M17-Project/M17_Repeater/schematics/tx_board_new/tx_board.pdf

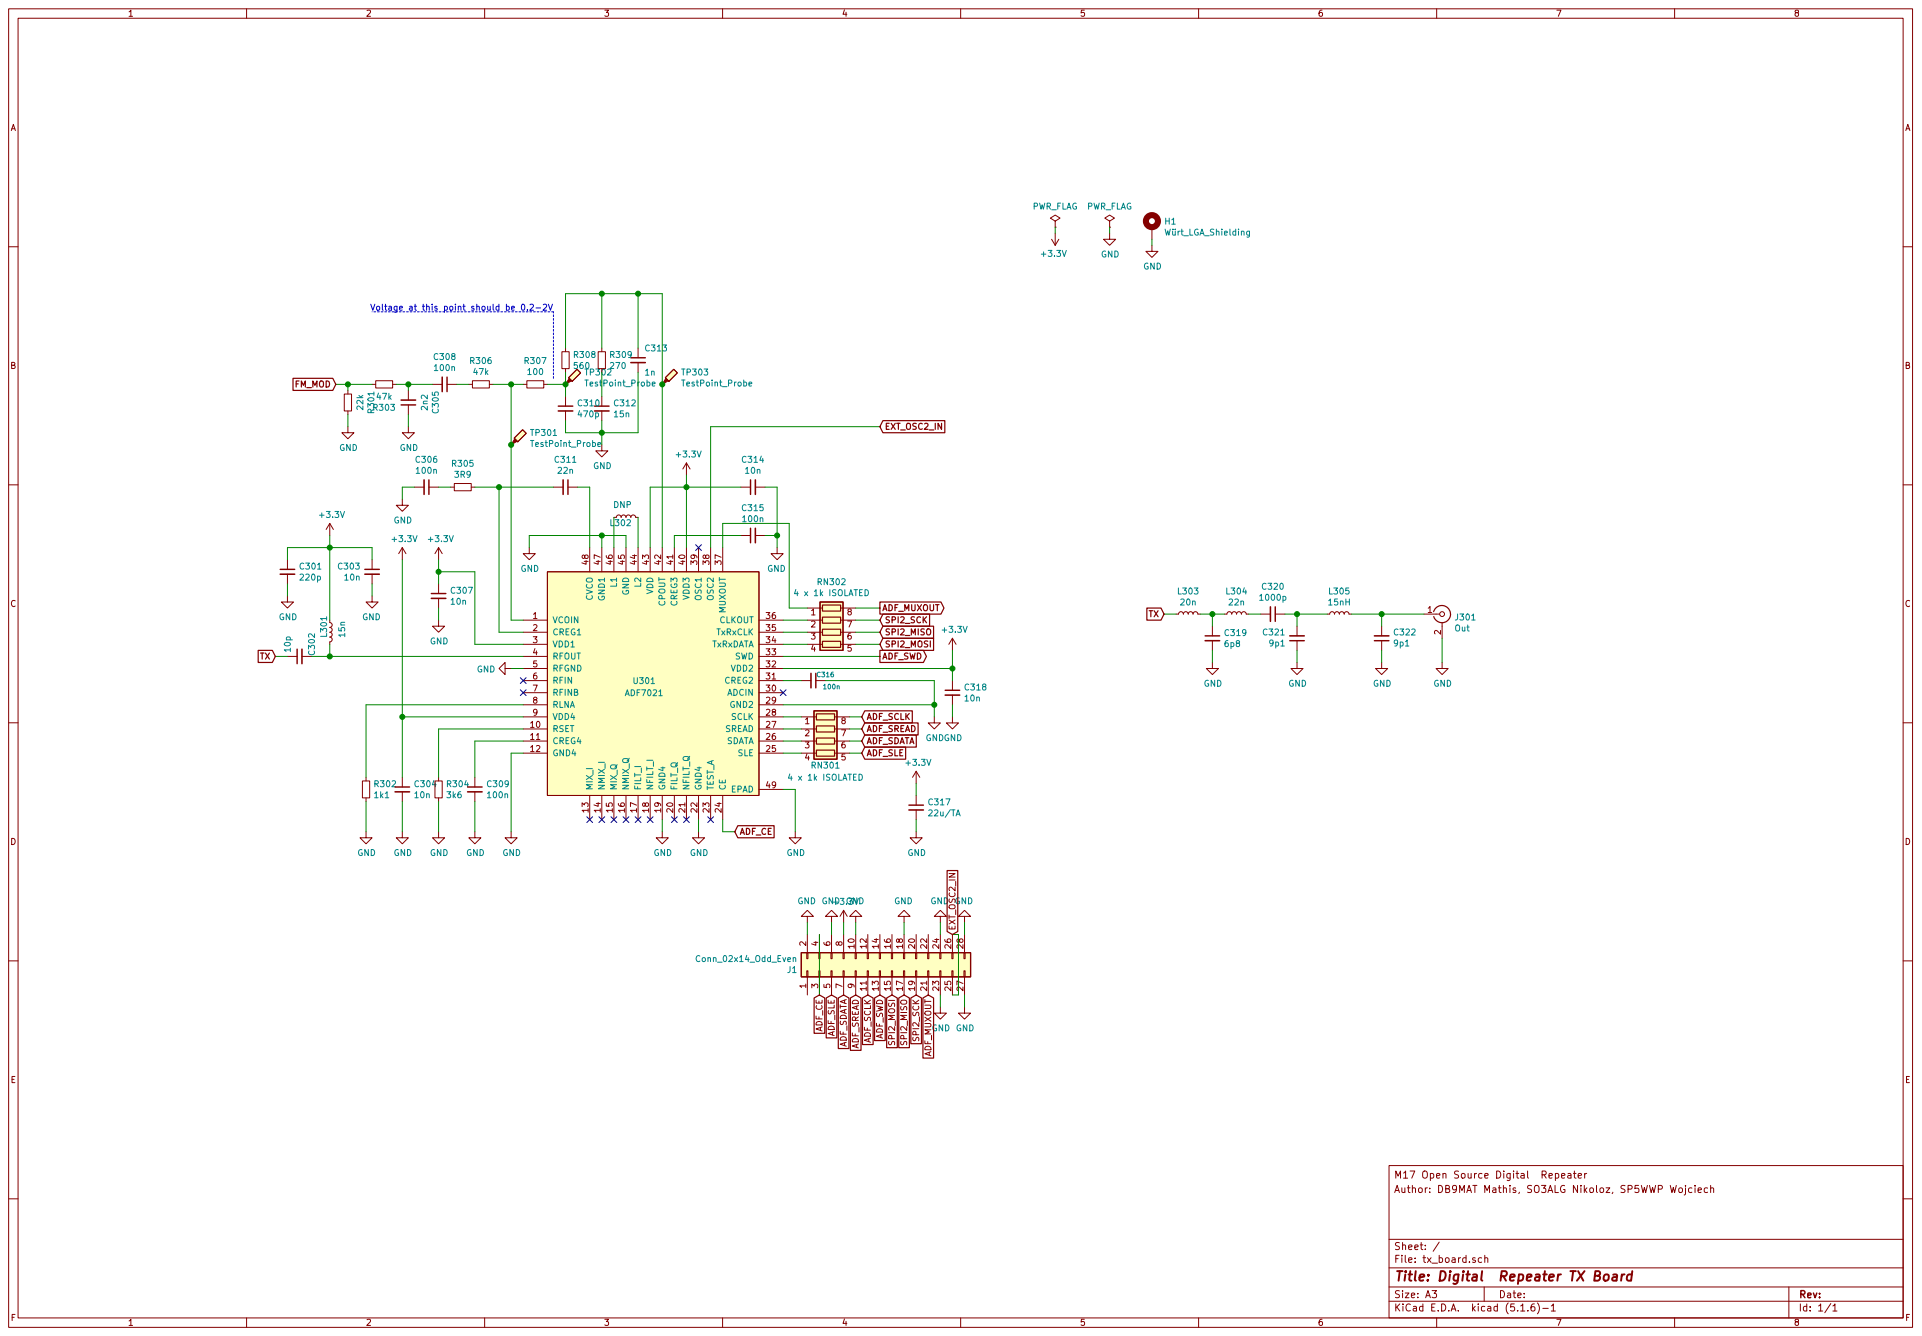
[picture p1: page 1]

SPI2_MOSI Voltage at this point should be 0.2-2V

M17 Open Source Digital Repeater
File: tx_board.sch Sheet: / Author: DB9MAT Mathis, SO3ALG Nikoloz, SP5WWP Wojciech

Id: 1/1 Title: Digital Repeater TX Board
