M17-Project/M17_Repeater/schematics/rx_board/rx_board.pdf

# GND ⁺³V³

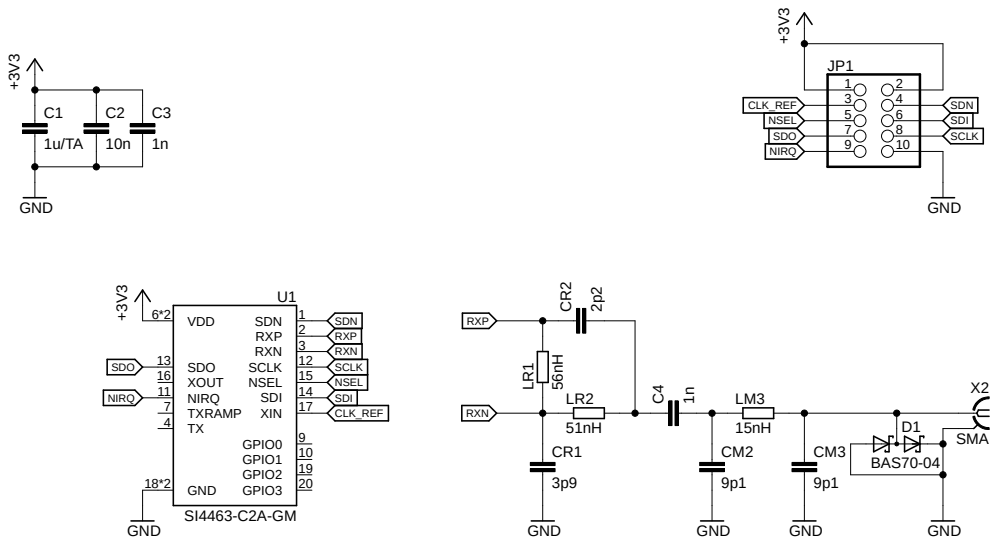
[picture p2: page 1]
SMA; 15nH ⁵⁶nH; GND; GND ⁺³V³; BAS70-04 ¹n; SDN; RXP; RXN; VDD 6*2; TXRAMP 7; GPIO0; GPIO1; NIRQ 11; SCLK; 12 SDO 13; SDI; 14 NSEL; 15 XOUT 16; XIN; GND 18*2; GPIO2; GPIO3; LM3 LR¹; CM3 CR²; CLK_REF; NSEL; SDO; NIRQ
