M17-Project/M17_Repeater/schematics/mainboard/mainboard.pdf

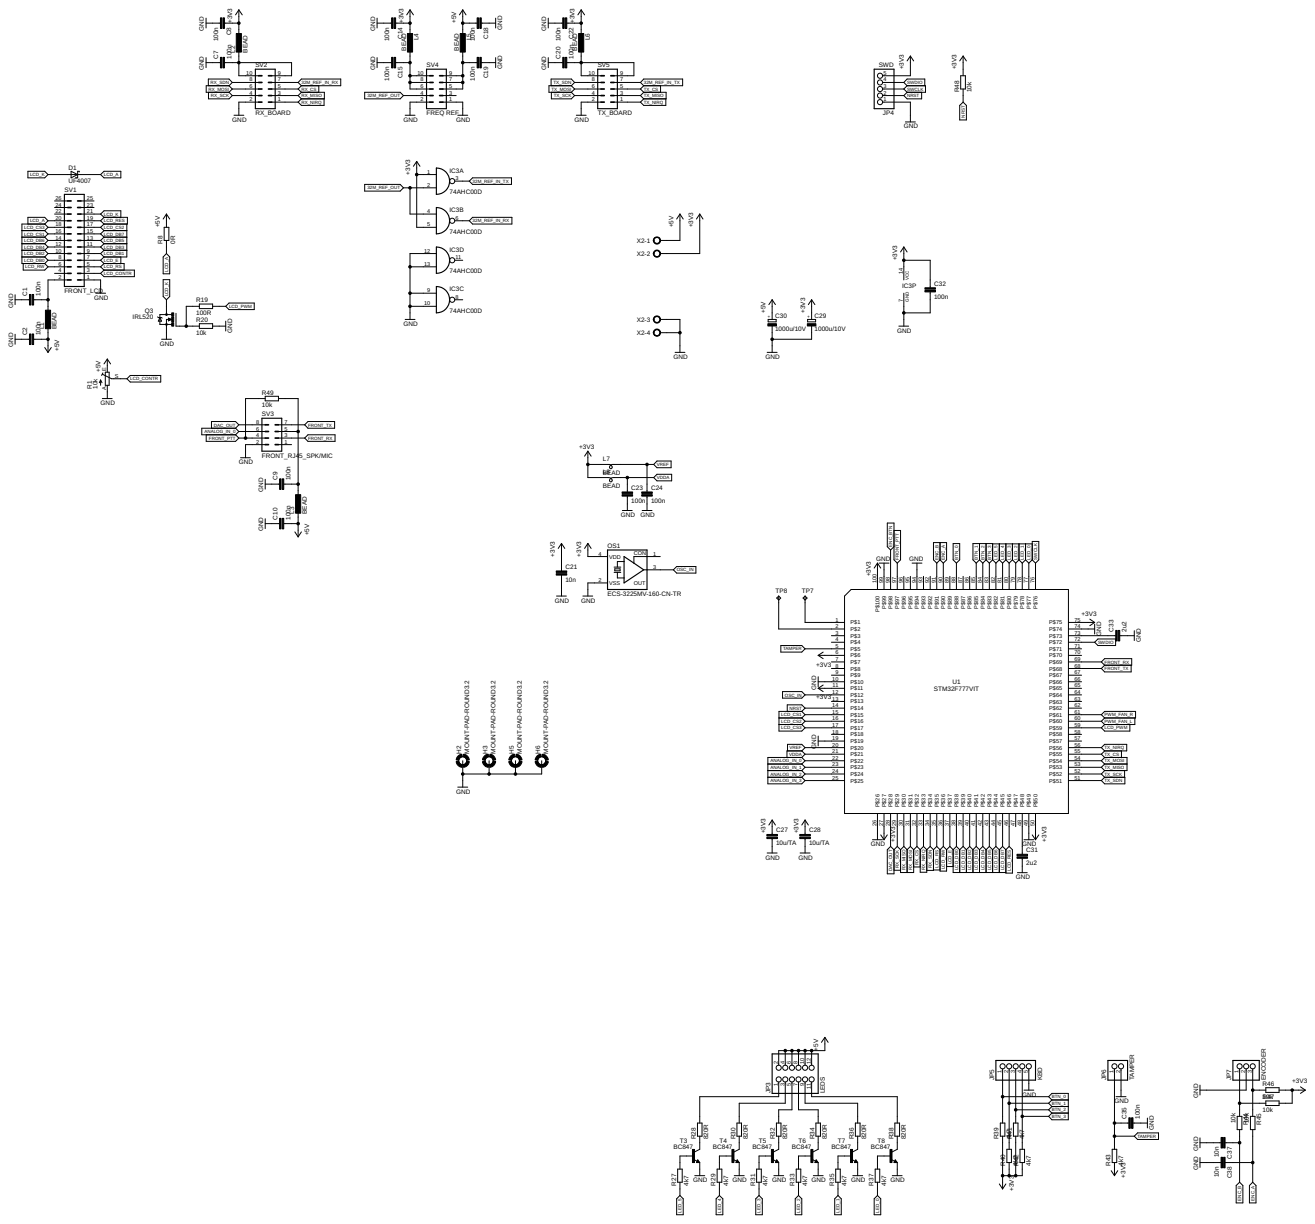
[picture p3: page 1]

4 | 3 1

MOUNT-PAD-ROUND3.2 MOUNT-PAD-ROUND3.2 MOUNT-PAD-ROUND3.2
