M17-Project/M17_Repeater/schematics/tx_board_new/tx_board.kicad_pcb

## KiCad design schematics/tx_board_new/tx_board.kicad_pcb (2020-09-21)

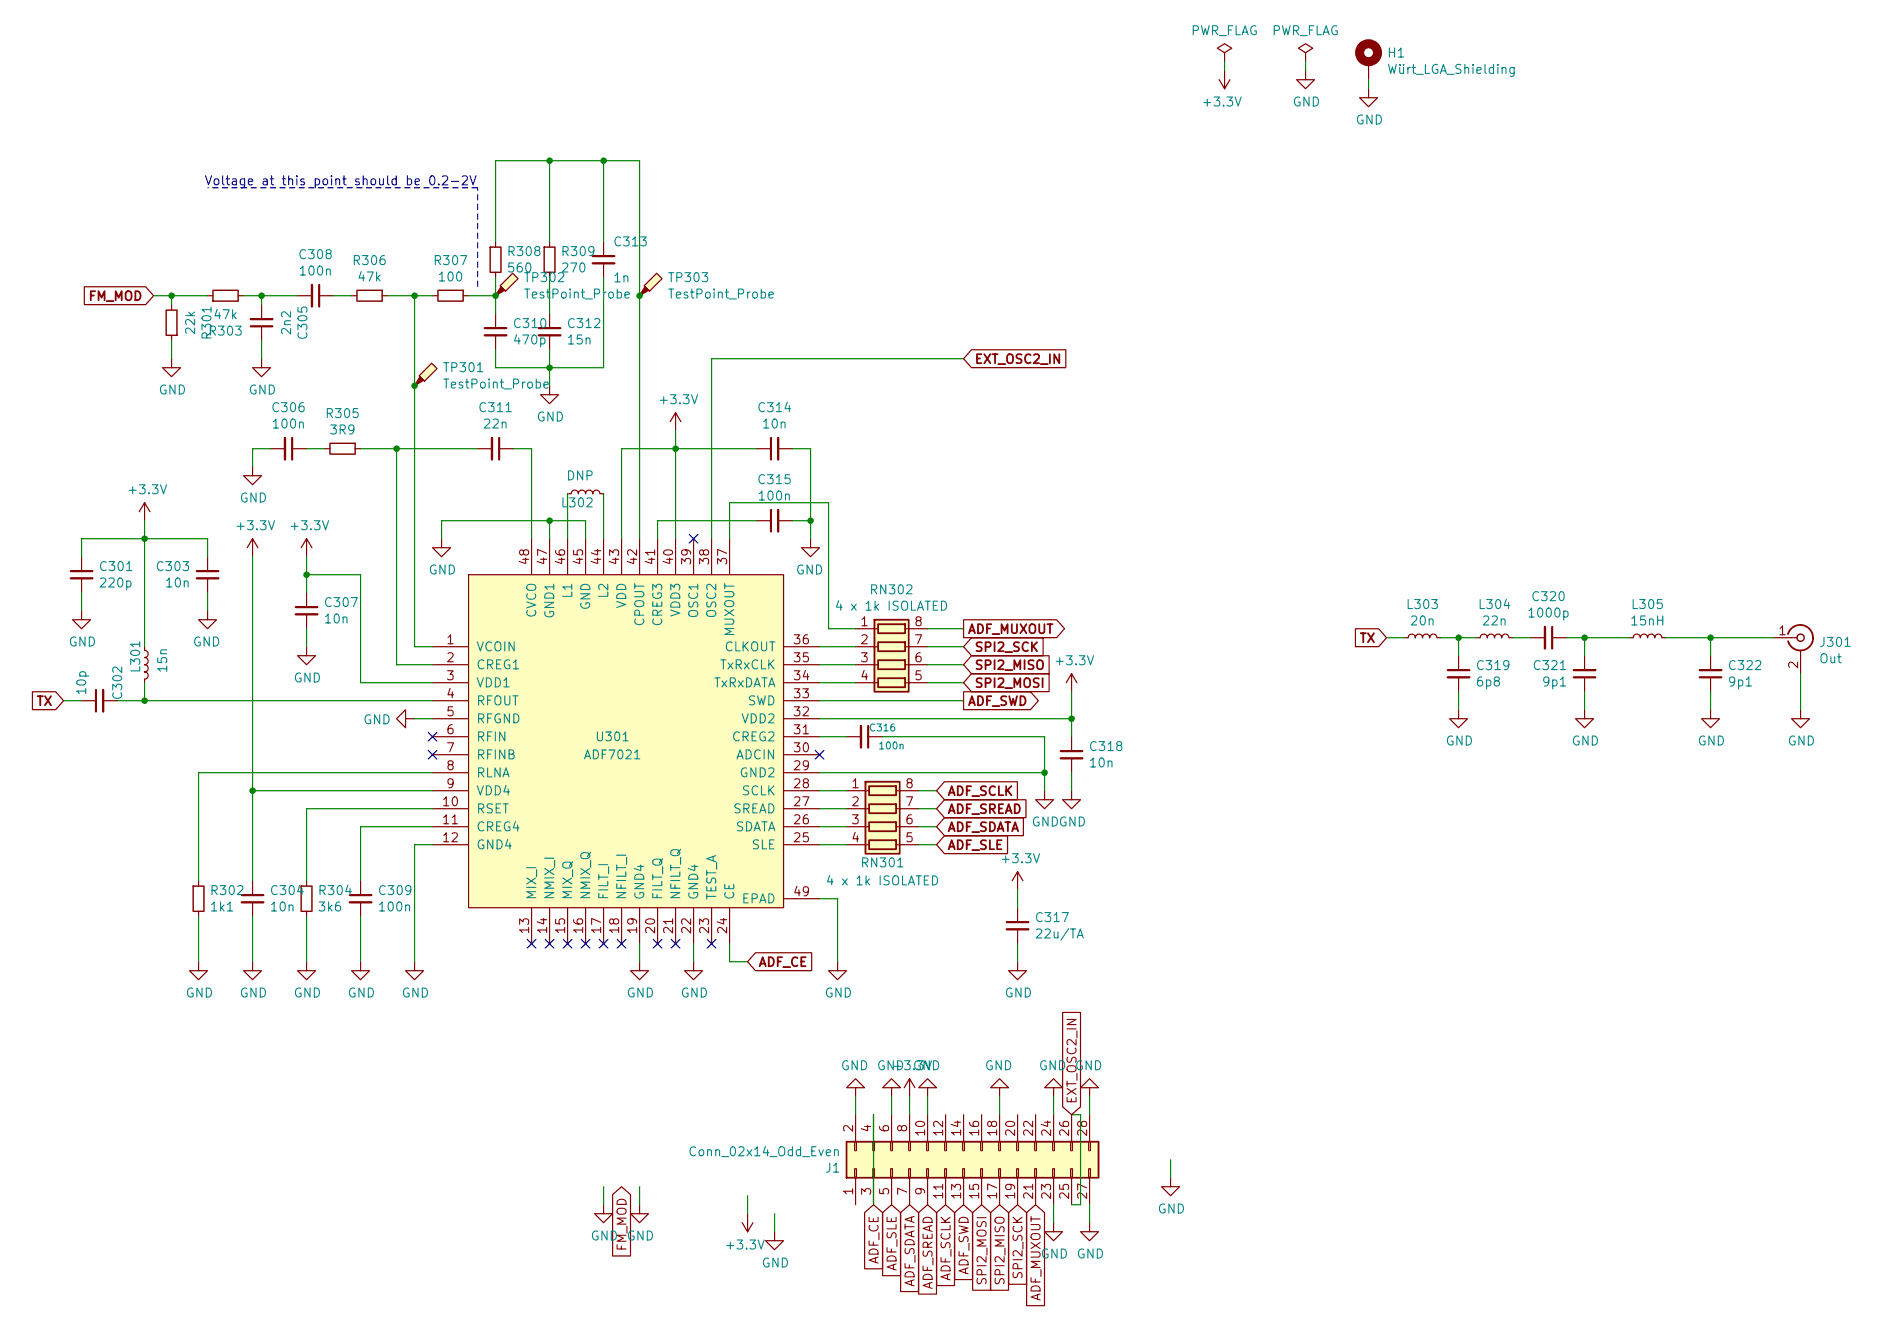
[picture p4: schematic tx_board.sch, Digital Repeater TX Board]

Parts:
C301: 220p; C_0603_1608Metric_Pad1.05x0.95mm_HandSolder; Voltage 50; Tolerance 5
C302: 10p; C_0603_1608Metric_Pad1.05x0.95mm_HandSolder; Voltage 50; Tolerance 5
C303, C304, C307, C314, C318: 10n; C_0603_1608Metric_Pad1.05x0.95mm_HandSolder; Tolerance 10; Voltage 50
C305: 2n2; C_0603_1608Metric_Pad1.05x0.95mm_HandSolder; Voltage 50; Tolerance 5
C306, C308, C309, C315, C316: 100n; C_0603_1608Metric_Pad1.05x0.95mm_HandSolder; Voltage 50; Tolerance 10
C310: 470p; C_0603_1608Metric_Pad1.05x0.95mm_HandSolder; Voltage 50; Tolerance 5
C311: 22n; C_0603_1608Metric_Pad1.05x0.95mm_HandSolder; Voltage 50; Tolerance 10
C312: 15n; C_0603_1608Metric_Pad1.05x0.95mm_HandSolder; Voltage 50; Tolerance 10
C313: 1n; C_0603_1608Metric_Pad1.05x0.95mm_HandSolder; Voltage 50; Tolerance 10
C317: 22u/TA; CP_EIA-3216-18_Kemet-A_Pad1.58x1.35mm_HandSolder; Tolerance 10; Voltage 10; Partno TAJA226K006RNJV
C319: 6p8; C_0603_1608Metric_Pad1.05x0.95mm_HandSolder; Voltage 50; Tolerance 5
C320: 1000p; C_0603_1608Metric_Pad1.05x0.95mm_HandSolder; Voltage 50; Tolerance 5
C321, C322: 9p1; C_0603_1608Metric_Pad1.05x0.95mm_HandSolder; Voltage 50; Tolerance 5
H1: Würt_LGA_Shielding; WE_36103205_SMD
J1: Conn_02x14_Odd_Even; edge_2x14pin
J301: Out; SMA_Samtec_SMA-J-P-X-ST-EM1_EdgeMount
L301: 15n; L_0603_1608Metric_Pad1.05x0.95mm_HandSolder
L302: DNP; L_0603_1608Metric_Pad1.05x0.95mm_HandSolder
L303: 20n; L_0603_1608Metric_Pad1.05x0.95mm_HandSolder
L304: 22n; L_0603_1608Metric_Pad1.05x0.95mm_HandSolder
L305: 15nH; L_0603_1608Metric_Pad1.05x0.95mm_HandSolder
R301: 22k; R_0603_1608Metric_Pad1.05x0.95mm_HandSolder; Tolerance 5
R302: 1k1; R_0603_1608Metric_Pad1.05x0.95mm_HandSolder; Tolerance 5
R303, R306: 47k; R_0603_1608Metric_Pad1.05x0.95mm_HandSolder; Tolerance 5
R304: 3k6; R_0603_1608Metric_Pad1.05x0.95mm_HandSolder; Tolerance 5
R305: 3R9; R_0603_1608Metric_Pad1.05x0.95mm_HandSolder; Tolerance 5
R307: 100; R_0603_1608Metric_Pad1.05x0.95mm_HandSolder; Tolerance 5
R308: 560; R_0603_1608Metric_Pad1.05x0.95mm_HandSolder; Tolerance 5
R309: 270; R_0603_1608Metric_Pad1.05x0.95mm_HandSolder; Tolerance 5
RN301, RN302: 4 x 1k ISOLATED; R_Array_Concave_4x0603; Tolerance 5
TP301, TP302, TP303: TestPoint_Probe; TestPoint_Pad_D1.0mm
U301: ADF7021; LFCSP-48-1EP_7x7mm_P0.5mm_EP4.1x4.1mm_ThermalVias

Connections:
+3V3: C301.1, C303.1, C304.1, C307.1, C314.1, C317.1, C318.1, J1.8, L301.1, U301.3 (VDD1), U301.9 (VDD4), U301.32 (VDD2), U301.40 (VDD3), U301.43 (VDD)
ADF_CE: J1.3, J1.4, U301.24 (CE)
ADF_MUXOUT: J1.21, RN302.8 (R1.2)
ADF_SCLK: J1.11, RN301.8 (R1.2)
ADF_SDATA: J1.7, RN301.6 (R3.2)
ADF_SLE: J1.5, RN301.5 (R4.2)
ADF_SREAD: J1.9, RN301.7 (R2.2)
ADF_SWD: J1.13, U301.33 (SWD)
EXT_OSC2_IN: J1.25, J1.26, U301.38 (OSC2)
FM_MOD: R301.2, R303.1
GND: C301.2, C303.2, C304.2, C305.1, C306.2, C307.2, C309.2, C310.2, C312.2, C313.2, C314.2, C315.2, C316.1, C317.2, C318.2, C319.2, C321.1, C322.1, H1.1, J1.2, J1.6, J1.10, J1.18, J1.23, J1.24, J1.27, J1.28, J301.2 (Ext), R301.1, R302.2, R304.2, U301.5 (RFGND), U301.12 (GND4), U301.19 (GND4), U301.22 (GND4), U301.29 (GND2), U301.45 (GND), U301.47 (GND1), U301.49 (EPAD)
unnamed: C302.2, L301.2, U301.4 (RFOUT)
unnamed: C305.2, C308.2, R303.2
unnamed: C306.1, R305.2
unnamed: C308.1, R306.2
unnamed: C309.1, U301.11 (CREG4)
unnamed: C310.1, R307.1, R308.2, TP302.1
unnamed: C311.1, U301.48 (CVCO)
unnamed: C311.2, R305.1, U301.2 (CREG1)
unnamed: C312.1, R309.2
unnamed: C313.1, R308.1, R309.1, TP303.1, U301.42 (CPOUT)
unnamed: C315.1, U301.41 (CREG3)
unnamed: C316.2, U301.31 (CREG2)
unnamed: C319.1, L303.2, L304.1
unnamed: C320.1, C321.2, L305.1
unnamed: C320.2, L304.2
unnamed: C322.2, J301.1 (In), L305.2
unnamed: L302.1, U301.46 (L1)
unnamed: L302.2, U301.44 (L2)
unnamed: R302.1, U301.8 (RLNA)
unnamed: R304.1, U301.10 (RSET)
unnamed: R306.1, R307.2, TP301.1, U301.1 (VCOIN)
unnamed: RN301.1 (R1.1), U301.28 (SCLK)
unnamed: RN301.2 (R2.1), U301.27 (SREAD)
unnamed: RN301.3 (R3.1), U301.26 (SDATA)
unnamed: RN301.4 (R4.1), U301.25 (SLE)
unnamed: RN302.1 (R1.1), U301.37 (MUXOUT)
unnamed: RN302.2 (R2.1), U301.36 (CLKOUT)
unnamed: RN302.3 (R3.1), U301.35 (TxRxCLK)
unnamed: RN302.4 (R4.1), U301.34 (TxRxDATA)
SPI2_MISO: J1.17, RN302.6 (R3.2)
SPI2_MOSI: J1.15, RN302.5 (R4.2)
SPI2_SCK: J1.19, RN302.7 (R2.2)
TX: C302.1, L303.1

Notes on the sheet:
Voltage at this point should be 0.2-2V

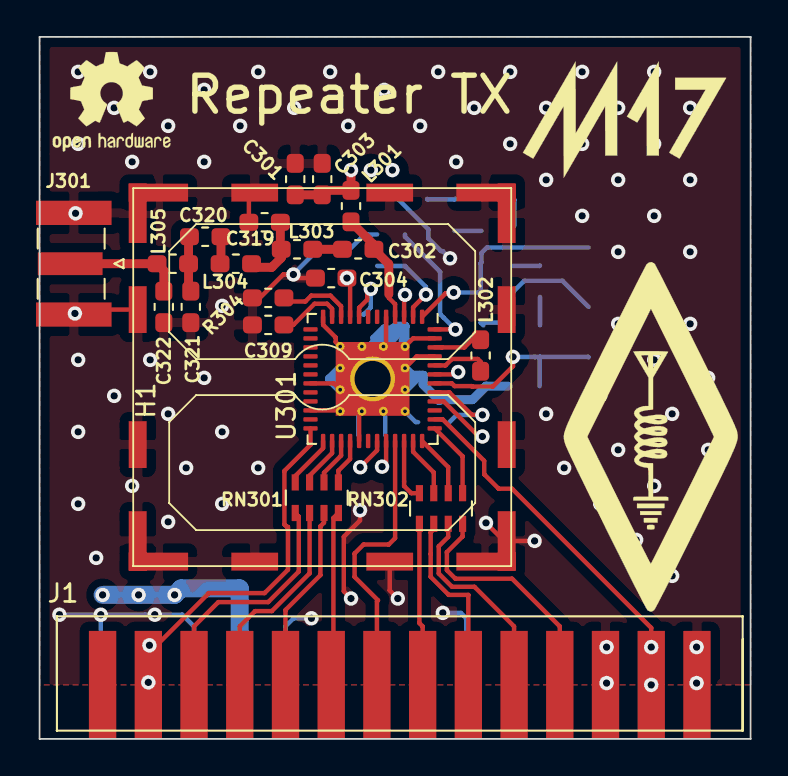
[picture p5: board tx_board.kicad_pcb from above]

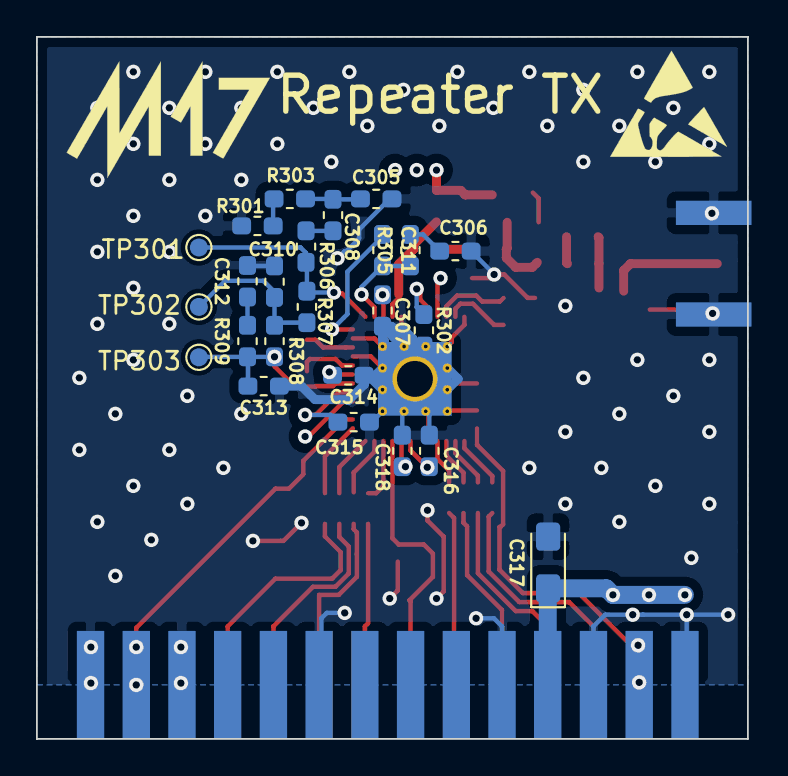
[picture p6: board tx_board.kicad_pcb from below]

Board: 4 copper layers, 39.5 x 39.0 mm, 45 parts (24 on the bottom side), 44 nets.
