M17-Project/M17_Repeater/schematics/supply_board/supply_board.brd

## EAGLE design schematics/supply_board/supply_board.brd (2019-11-05)

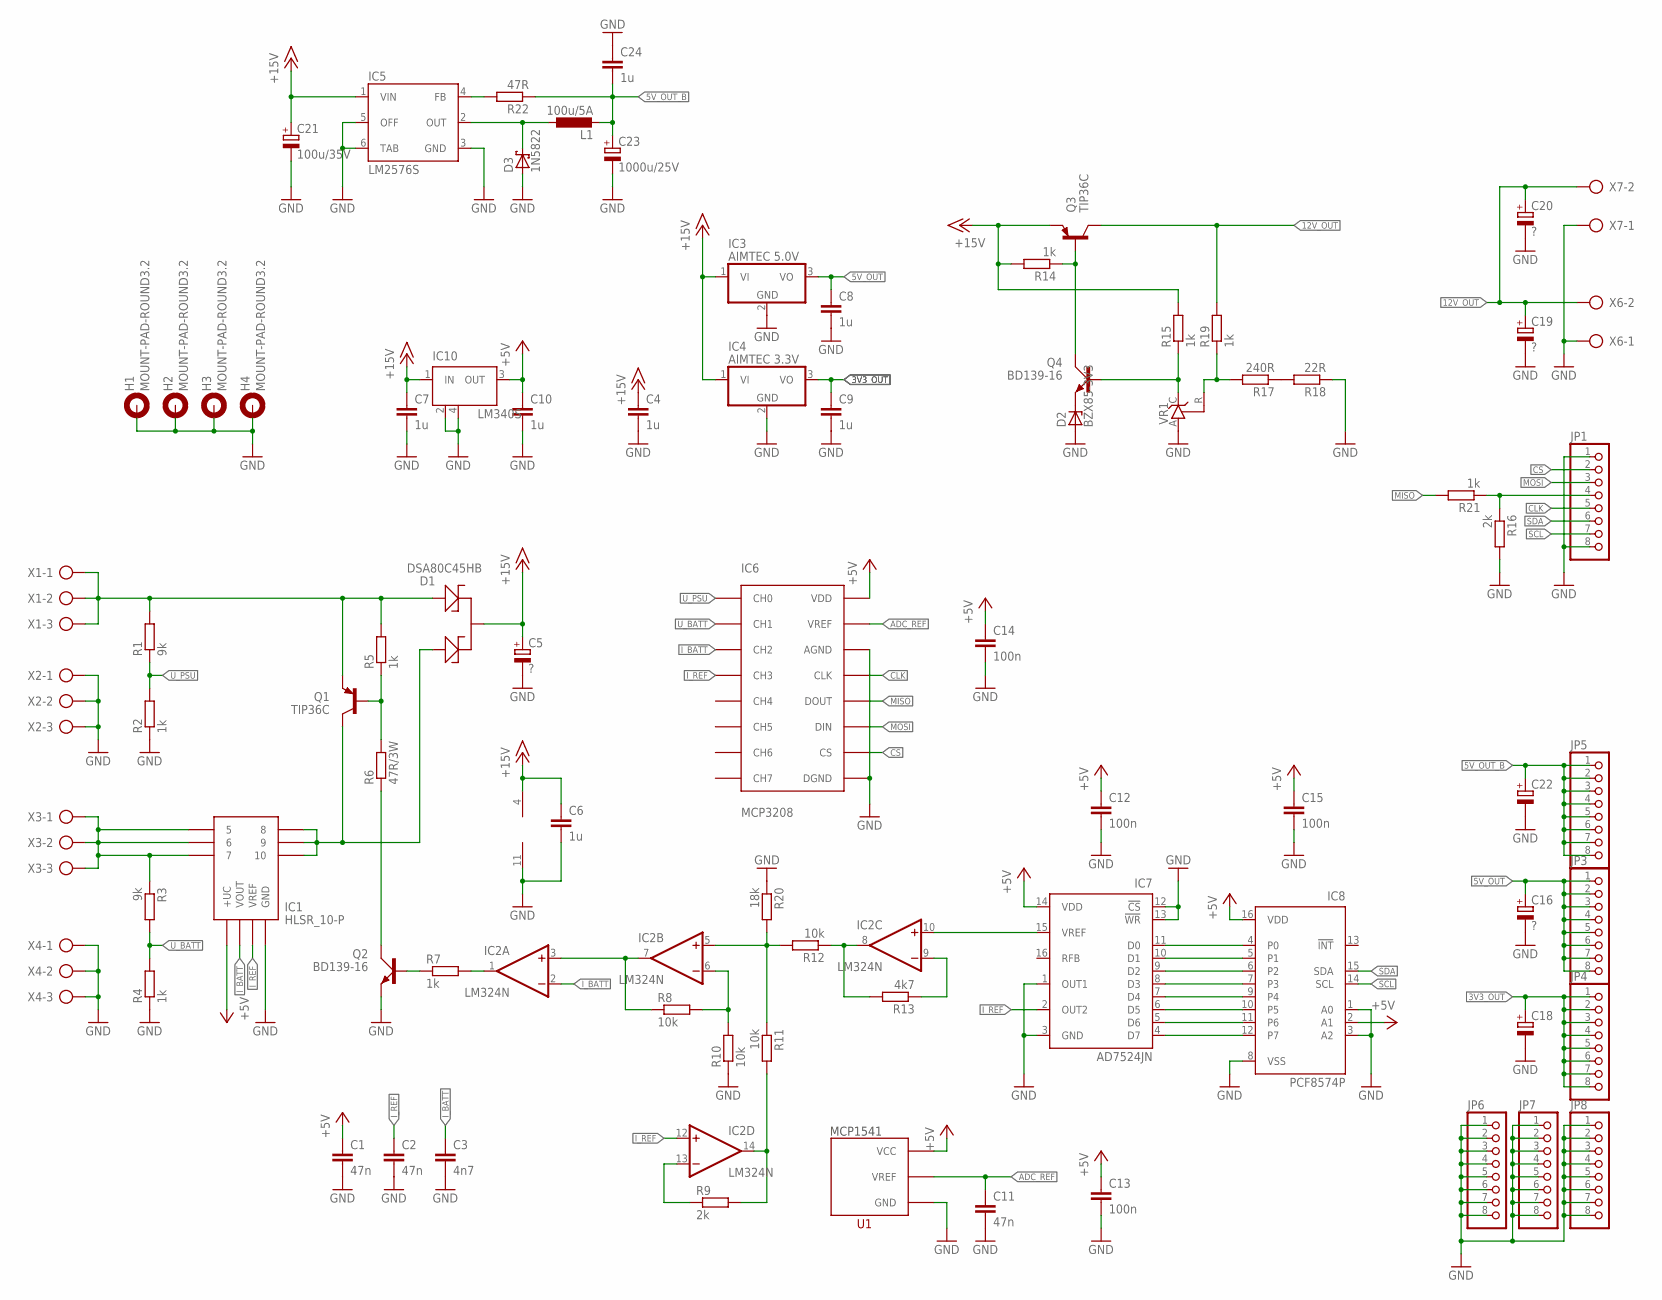
[picture p7: schematic supply_board.sch]

Parts:
C1, C2, C11: 47n; C0805
C3: 4n7; C0805
C4, C6, C7, C8, C9, C10, C24: 1u; C0805
C5, C19, C20: ?; E5-13
C12, C13, C14, C15: 100n; C0805
C16: ?; E2,5-6
C18, C22: CPOL-EUE2.5-6; E2,5-6
C21: 100u/35V; E5-10,5
C23: 1000u/25V; E5-10,5
D1: DSA80C45HB; TO247BV
D2: BZX85-3V3; DO41Z10
D3: 1N5822; C4111-15
H1, H2, H3, H4: MOUNT-PAD-ROUND3.2; 3,2-PAD
IC1: HLSR_10-P; HLSR16-P
IC2: LM324N; DIL14
IC3: AIMTEC 5.0V; TO220V
IC4: AIMTEC 3.3V; TO220V
IC5: LM2576S; TO263-5
IC6: MCP3208; DIL16
IC7: AD7524JN; DIL16
IC8: PCF8574P; DIL16
IC10: LM340S; SOT223
JP1, JP3, JP4, JP5, JP6, JP7, JP8: PINHD-1X8; 1X08
L1: 100u/5A; TJ5-U2
Q1, Q3: TIP36C; TO247-V
Q2, Q4: BD139-16; TO126AV
R1, R3: 9k; R0805
R2, R4, R5, R7, R14, R15, R19, R21: 1k; R0805
R6: 47R/3W; 0617/22
R8, R10, R11, R12: 10k; R0805
R9, R16: 2k; R0805
R13: 4k7; R0805
R17: 240R; R0805
R18: 22R; R0805
R20: 18k; R0805
R22: 47R; R0805
U1: VOLT_REFERENCE; SOT23
VR1: TL431CLP; TO92-CLP
X1, X2, X3, X4: AK500/3
X6, X7: AK500/2

Connections:
3V3_OUT: C9.1, C18.+, IC4.3 (VO), JP4.1, JP4.2, JP4.3, JP4.4, JP4.5, JP4.6, JP4.7, JP4.8
5V_OUT: C8.1, C16.+, IC3.3 (VO), JP3.1, JP3.2, JP3.3, JP3.4, JP3.5, JP3.6, JP3.7, JP3.8
5V_OUT_B: C22.+, C23.+, C24.2, JP5.1, JP5.2, JP5.3, JP5.4, JP5.5, JP5.6, JP5.7, JP5.8, L1.2, R22.1
12V_OUT: C19.+, C20.+, Q3.2 (C), R19.2, X6.2, X7.2
+5V: C1.1, C10.1, C12.1, C13.1, C14.1, C15.1, IC1.4 (+UC), IC6.VDD, IC7.14 (VDD), IC8.2 (A1), IC8.16 (VDD), IC10.3 (OUT), U1.1 (VCC)
+15V: C4.1, C5.+, C6.1, C7.1, C21.+, D1.2, IC2.4 (V+), IC3.1 (VI), IC4.1 (VI), IC5.1 (VIN), IC10.1 (IN), Q3.3 (E), R14.2, R15.2
ADC_REF: C11.1, IC6.VREF, U1.2 (VREF)
CLK: IC6.CLK, JP1.5
CS: IC6.CS, JP1.2
GND: C1.2, C2.2, C3.2, C4.2, C5.-, C6.2, C7.2, C8.2, C9.2, C10.2, C11.2, C12.2, C13.2, C14.2, C15.2, C16.-, C18.-, C19.-, C20.-, C21.-, C22.-, C23.-, C24.1, D2.A, D3.A, H1.B3,2, H2.B3,2, H3.B3,2, H4.B3,2, IC1.3 (GND), IC2.11 (V-), IC3.2 (GND), IC4.2 (GND), IC5.3 (GND), IC5.5 (OFF), IC5.6 (TAB), IC6.AGND, IC6.DGND, IC7.1 (OUT1), IC7.3 (GND), IC7.12 (!CS), IC7.13 (!WR), IC8.1 (A0), IC8.3 (A2), IC8.8 (VSS), IC10.2 (GND), IC10.4 (GND), JP1.1, JP1.8, JP6.1, JP6.2, JP6.3, JP6.4, JP6.5, JP6.6, JP6.7, JP6.8, JP7.1, JP7.2, JP7.3, JP7.4, JP7.5, JP7.6, JP7.7, JP7.8, JP8.1, JP8.2, JP8.3, JP8.4, JP8.5, JP8.6, JP8.7, JP8.8, Q2.E, R2.1, R4.1, R10.1, R16.2, R18.1, R20.1, U1.3 (GND), VR1.A, X2.1, X2.2, X2.3, X4.1, X4.2, X4.3, X6.1, X7.1
I_BATT: C3.1, IC1.2 (VOUT), IC2.2 (-IN), IC6.CH2
I_REF: C2.1, IC1.1 (VREF), IC2.12 (+IN), IC6.CH3, IC7.2 (OUT2)
MISO: IC6.DOUT, R21.2
MOSI: IC6.DIN, JP1.3
unnamed: IC1.5, IC1.6, IC1.7, R3.1, X3.1, X3.2, X3.3
unnamed: D1.3, IC1.8, IC1.9, IC1.10, Q1.2 (C)
unnamed: Q1.1 (B), R5.1, R6.2
unnamed: Q2.C, R6.1
unnamed: IC2.6 (-IN), R8.2, R10.2
unnamed: D1.1, Q1.3 (E), R1.2, R5.2, X1.1, X1.2, X1.3
unnamed: Q2.B, R7.1
unnamed: IC2.1 (OUT), R7.2
unnamed: IC2.13 (-IN), R9.1
unnamed: IC2.3 (+IN), IC2.7 (OUT), R8.1
unnamed: IC2.14 (OUT), R9.2, R11.2
unnamed: IC2.5 (+IN), R11.1, R12.2, R20.2
unnamed: IC2.8 (OUT), R12.1, R13.2
unnamed: IC7.11 (D0), IC8.4 (P0)
unnamed: IC7.10 (D1), IC8.5 (P1)
unnamed: IC7.9 (D2), IC8.6 (P2)
unnamed: IC7.8 (D3), IC8.7 (P3)
unnamed: Q3.1 (B), Q4.C, R14.1
unnamed: IC7.7 (D4), IC8.9 (P4)
unnamed: IC7.6 (D5), IC8.10 (P5)
unnamed: IC7.5 (D6), IC8.11 (P6)
unnamed: IC7.4 (D7), IC8.12 (P7)
unnamed: Q4.B, R15.1, VR1.C
unnamed: D2.C, Q4.E
unnamed: IC2.9 (-IN), R13.1
unnamed: IC2.10 (+IN), IC7.15 (VREF)
unnamed: JP1.4, R16.1, R21.1
unnamed: R17.1, R18.2
unnamed: IC5.4 (FB), R22.2
unnamed: R17.2, R19.1, VR1.R
unnamed: D3.C, IC5.2 (OUT), L1.1
SCL: IC8.14 (SCL), JP1.7
SDA: IC8.15 (SDA), JP1.6
U_BATT: IC6.CH1, R3.2, R4.2
U_PSU: IC6.CH0, R1.1, R2.2

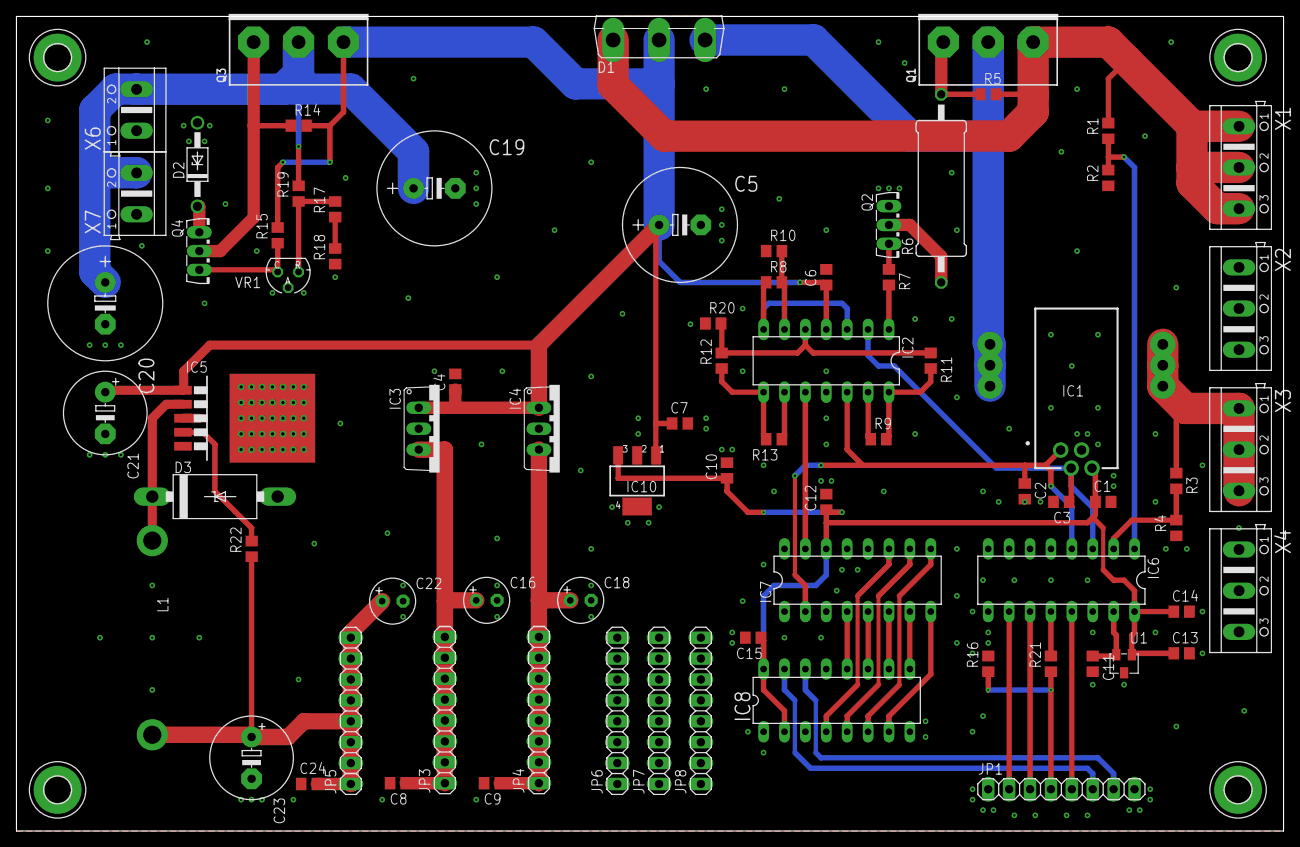
[picture p8: board supply_board.brd from above]

Board: 2 copper layers, 154.0 x 99.0 mm, 81 parts (0 on the bottom side), 49 nets.
