M17-Project/M17_Repeater/schematics/fan_ctrl/fan_ctrl.brd

## EAGLE design schematics/fan_ctrl/fan_ctrl.brd (2019-10-07)

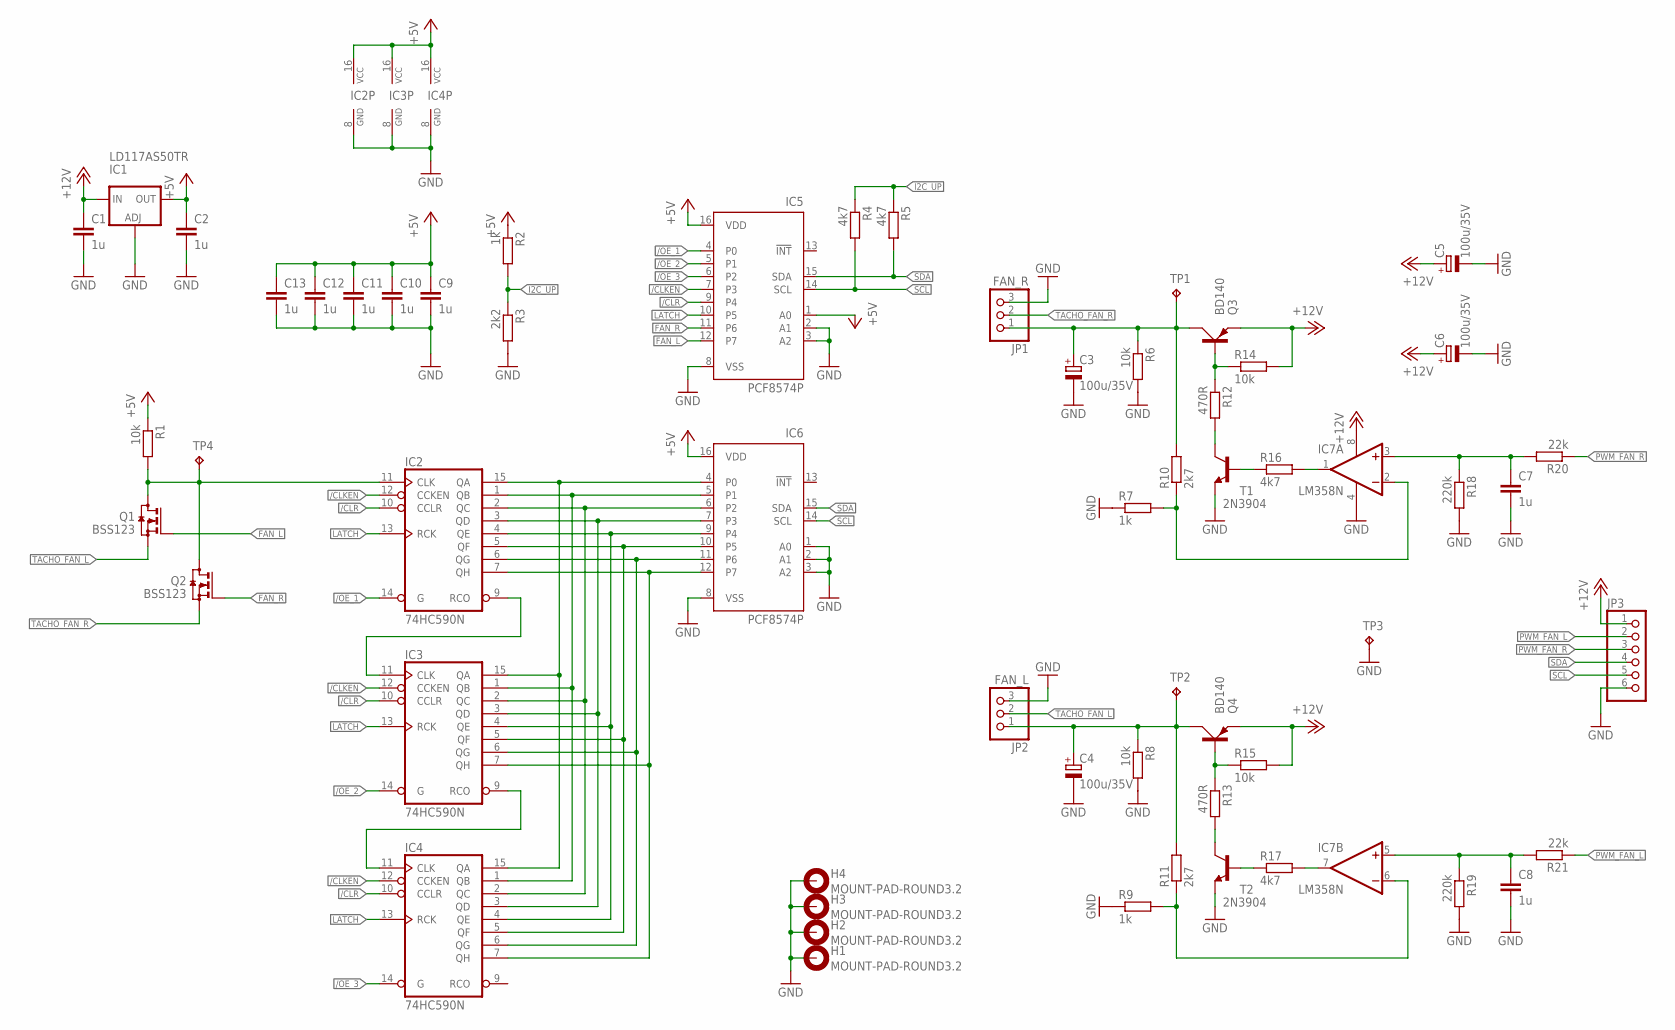
[picture p9: schematic fan_ctrl.sch]

Parts:
C1, C2, C7, C8, C9, C10, C11, C12, C13: 1u; C0805
C3, C4, C5, C6: 100u/35V; E3,5-8
H1, H2, H3, H4: MOUNT-PAD-ROUND3.2; 3,2-PAD
IC1: LD117AS50TR; SOT223
IC2, IC3, IC4: 74HC590N; DIL16
IC5, IC6: PCF8574P; DIL16
IC7: LM358N; DIL08
JP1: FAN_R; 1X03
JP2: FAN_L; 1X03
JP3: PINHD-1X6; 1X06
Q1, Q2: BSS123; SOT23
Q3, Q4: BD140; TO126AV
R1, R6, R8, R14, R15: 10k; R0805
R2, R7, R9: 1k; R0805
R3: 2k2; R0805
R4, R5, R16, R17: 4k7; R0805
R10, R11: 2k7; R0805
R12, R13: 470R; R0805
R18, R19: 220k; R0805
R20, R21: 22k; R0805
T1, T2: 2N3904; TO92-EBC
TP1, TP2, TP3, TP4: TPB2,54; B2,54

Connections:
+5V: C2.1, C9.1, C10.1, C11.1, C12.1, C13.1, IC1.4 (OUT), IC2.16 (VCC), IC3.16 (VCC), IC4.16 (VCC), IC5.1 (A0), IC5.16 (VDD), IC6.16 (VDD), R1.1, R2.1
+12V: C1.1, C5.+, C6.+, IC1.3 (IN), IC7.8 (V+), JP3.1, Q3.E, Q4.E, R14.2, R15.2
/CLKEN: IC2.12 (CCKEN), IC3.12 (CCKEN), IC4.12 (CCKEN), IC5.7 (P3)
/CLR: IC2.10 (CCLR), IC3.10 (CCLR), IC4.10 (CCLR), IC5.9 (P4)
/OE_1: IC2.14 (G), IC5.4 (P0)
/OE_2: IC3.14 (G), IC5.5 (P1)
/OE_3: IC4.14 (G), IC5.6 (P2)
FAN_L: IC5.12 (P7), Q1.1 (G)
FAN_R: IC5.11 (P6), Q2.1 (G)
GND: C1.2, C2.2, C3.-, C4.-, C5.-, C6.-, C7.2, C8.2, C9.2, C10.2, C11.2, C12.2, C13.2, H1.B3,2, H2.B3,2, H3.B3,2, H4.B3,2, IC1.1 (ADJ), IC2.8 (GND), IC3.8 (GND), IC4.8 (GND), IC5.2 (A1), IC5.3 (A2), IC5.8 (VSS), IC6.1 (A0), IC6.2 (A1), IC6.3 (A2), IC6.8 (VSS), IC7.4 (V-), JP1.3, JP2.3, JP3.6, R3.2, R6.2, R7.1, R8.2, R9.1, R18.2, R19.2, T1.E, T2.E, TP3.TP
I2C_UP: R2.2, R3.1, R4.1, R5.1
LATCH: IC2.13 (RCK), IC3.13 (RCK), IC4.13 (RCK), IC5.10 (P5)
unnamed: IC2.15 (QA), IC3.15 (QA), IC4.15 (QA), IC6.4 (P0)
unnamed: IC2.1 (QB), IC3.1 (QB), IC4.1 (QB), IC6.5 (P1)
unnamed: IC2.2 (QC), IC3.2 (QC), IC4.2 (QC), IC6.6 (P2)
unnamed: IC2.3 (QD), IC3.3 (QD), IC4.3 (QD), IC6.7 (P3)
unnamed: IC2.4 (QE), IC3.4 (QE), IC4.4 (QE), IC6.9 (P4)
unnamed: IC2.11 (CLK), Q1.3 (D), Q2.3 (D), R1.2, TP4.TP
unnamed: IC2.6 (QG), IC3.6 (QG), IC4.6 (QG), IC6.11 (P6)
unnamed: C7.1, IC7.3 (+IN), R18.1, R20.2
unnamed: R12.2, T1.C
unnamed: C8.1, IC7.5 (+IN), R19.1, R21.2
unnamed: Q3.B, R12.1, R14.1
unnamed: IC3.9 (RCO), IC4.11 (CLK)
unnamed: R13.2, T2.C
unnamed: C3.+, JP1.1, Q3.C, R6.1, R10.2, TP1.TP
unnamed: IC7.6 (-IN), R9.2, R11.1
unnamed: Q4.B, R13.1, R15.1
unnamed: R16.1, T1.B
unnamed: C4.+, JP2.1, Q4.C, R8.1, R11.2, TP2.TP
unnamed: IC7.2 (-IN), R7.2, R10.1
unnamed: IC7.1 (OUT), R16.2
unnamed: R17.1, T2.B
unnamed: IC7.7 (OUT), R17.2
unnamed: IC2.9 (RCO), IC3.11 (CLK)
unnamed: IC2.5 (QF), IC3.5 (QF), IC4.5 (QF), IC6.10 (P5)
unnamed: IC2.7 (QH), IC3.7 (QH), IC4.7 (QH), IC6.12 (P7)
PWM_FAN_L: JP3.2, R21.1
PWM_FAN_R: JP3.3, R20.1
SCL: IC5.14 (SCL), IC6.14 (SCL), JP3.5, R4.2
SDA: IC5.15 (SDA), IC6.15 (SDA), JP3.4, R5.2
TACHO_FAN_L: JP2.2, Q1.2 (S)
TACHO_FAN_R: JP1.2, Q2.2 (S)

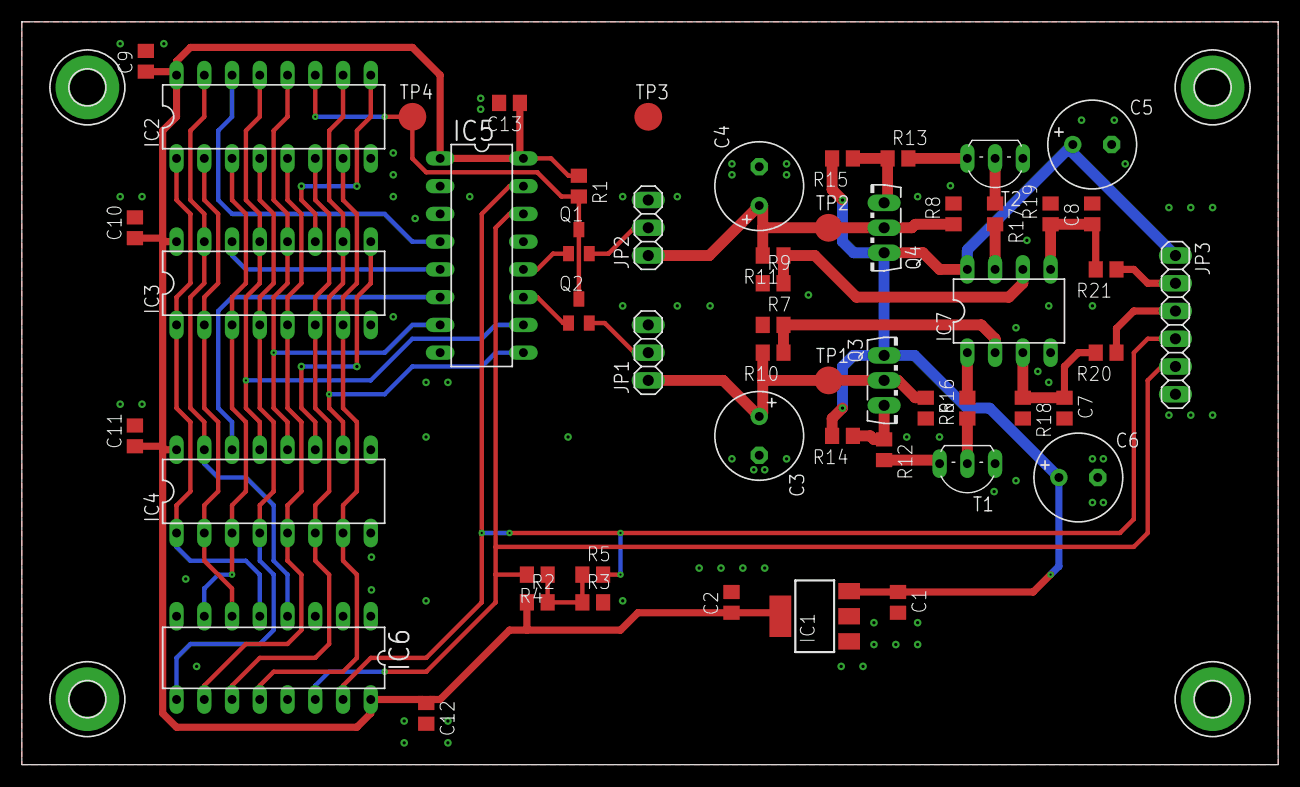
[picture p10: board fan_ctrl.brd from above]

Board: 2 copper layers, 115.0 x 68.0 mm, 58 parts (0 on the bottom side), 43 nets.
