M17-Project/M17_Repeater/schematics/mainboard/mainboard.brd

## EAGLE design schematics/mainboard/mainboard.brd (2019-10-06)

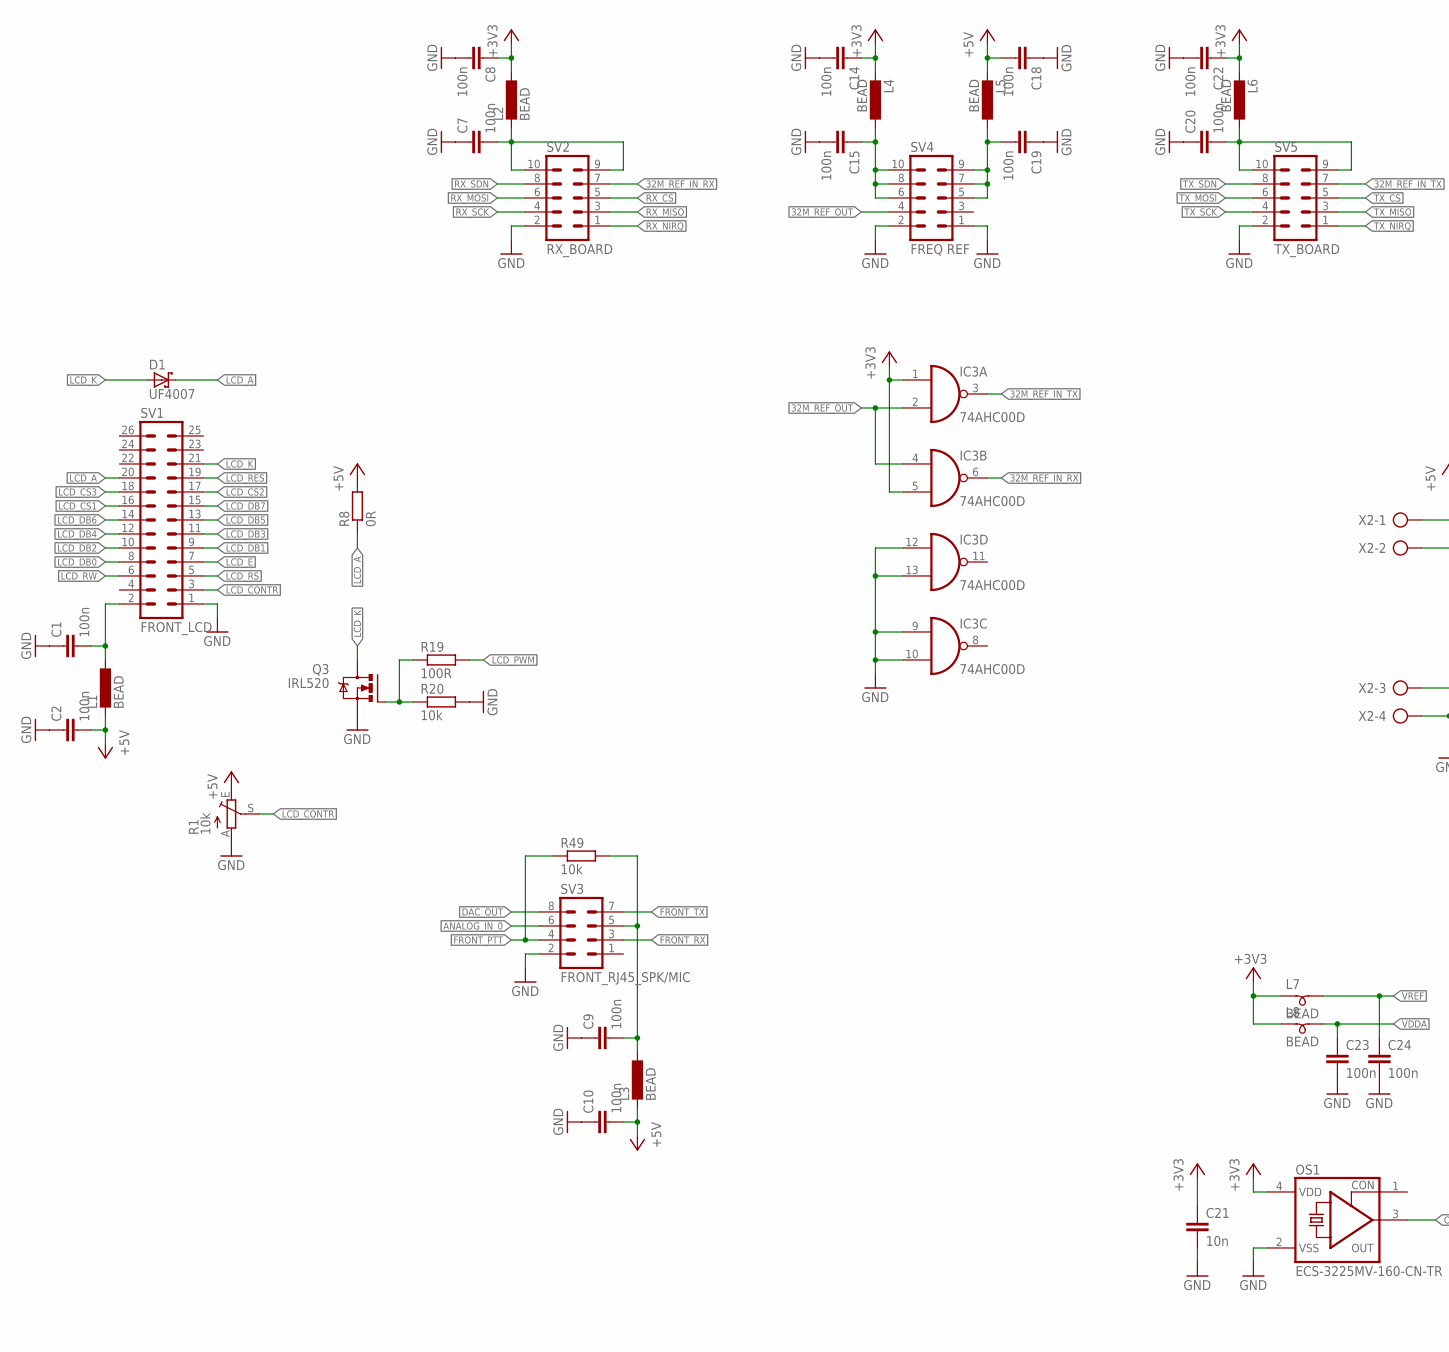
[picture p11: schematic mainboard.sch, part in row 1, column 1]

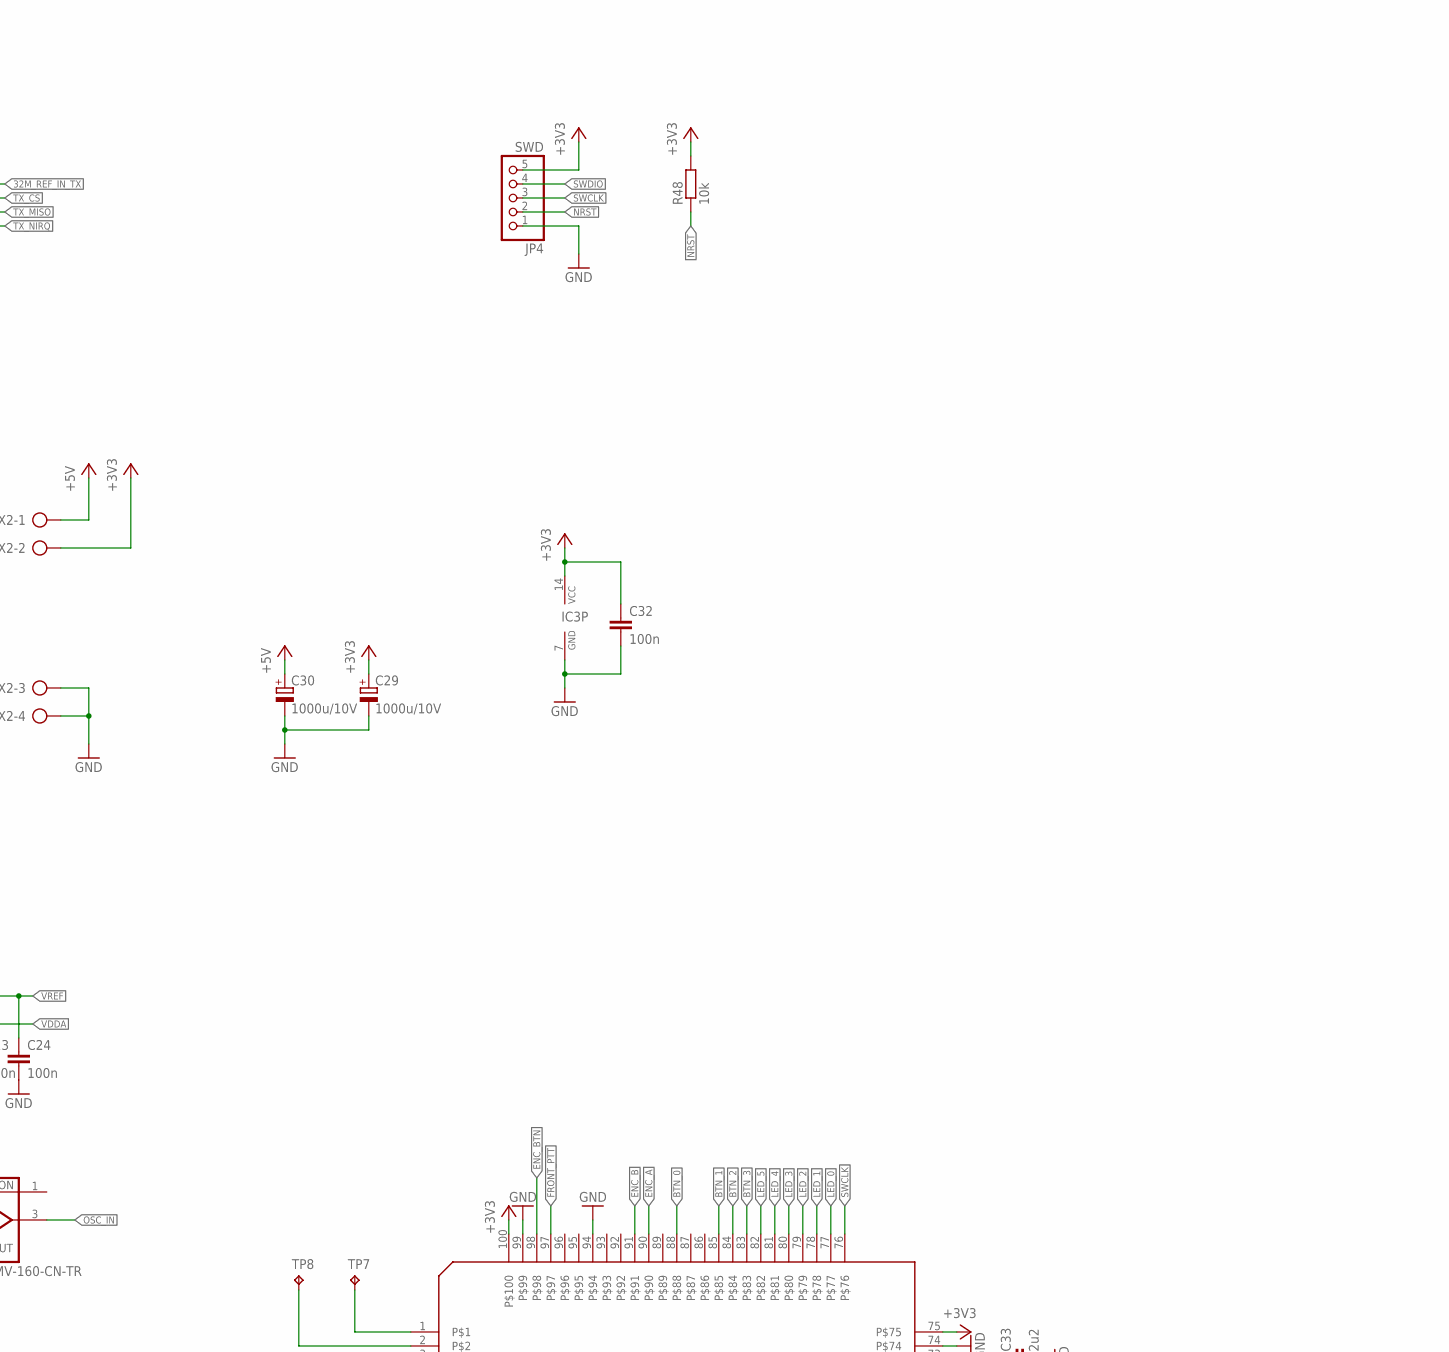
[picture p12: schematic mainboard.sch, part in row 1, column 2]

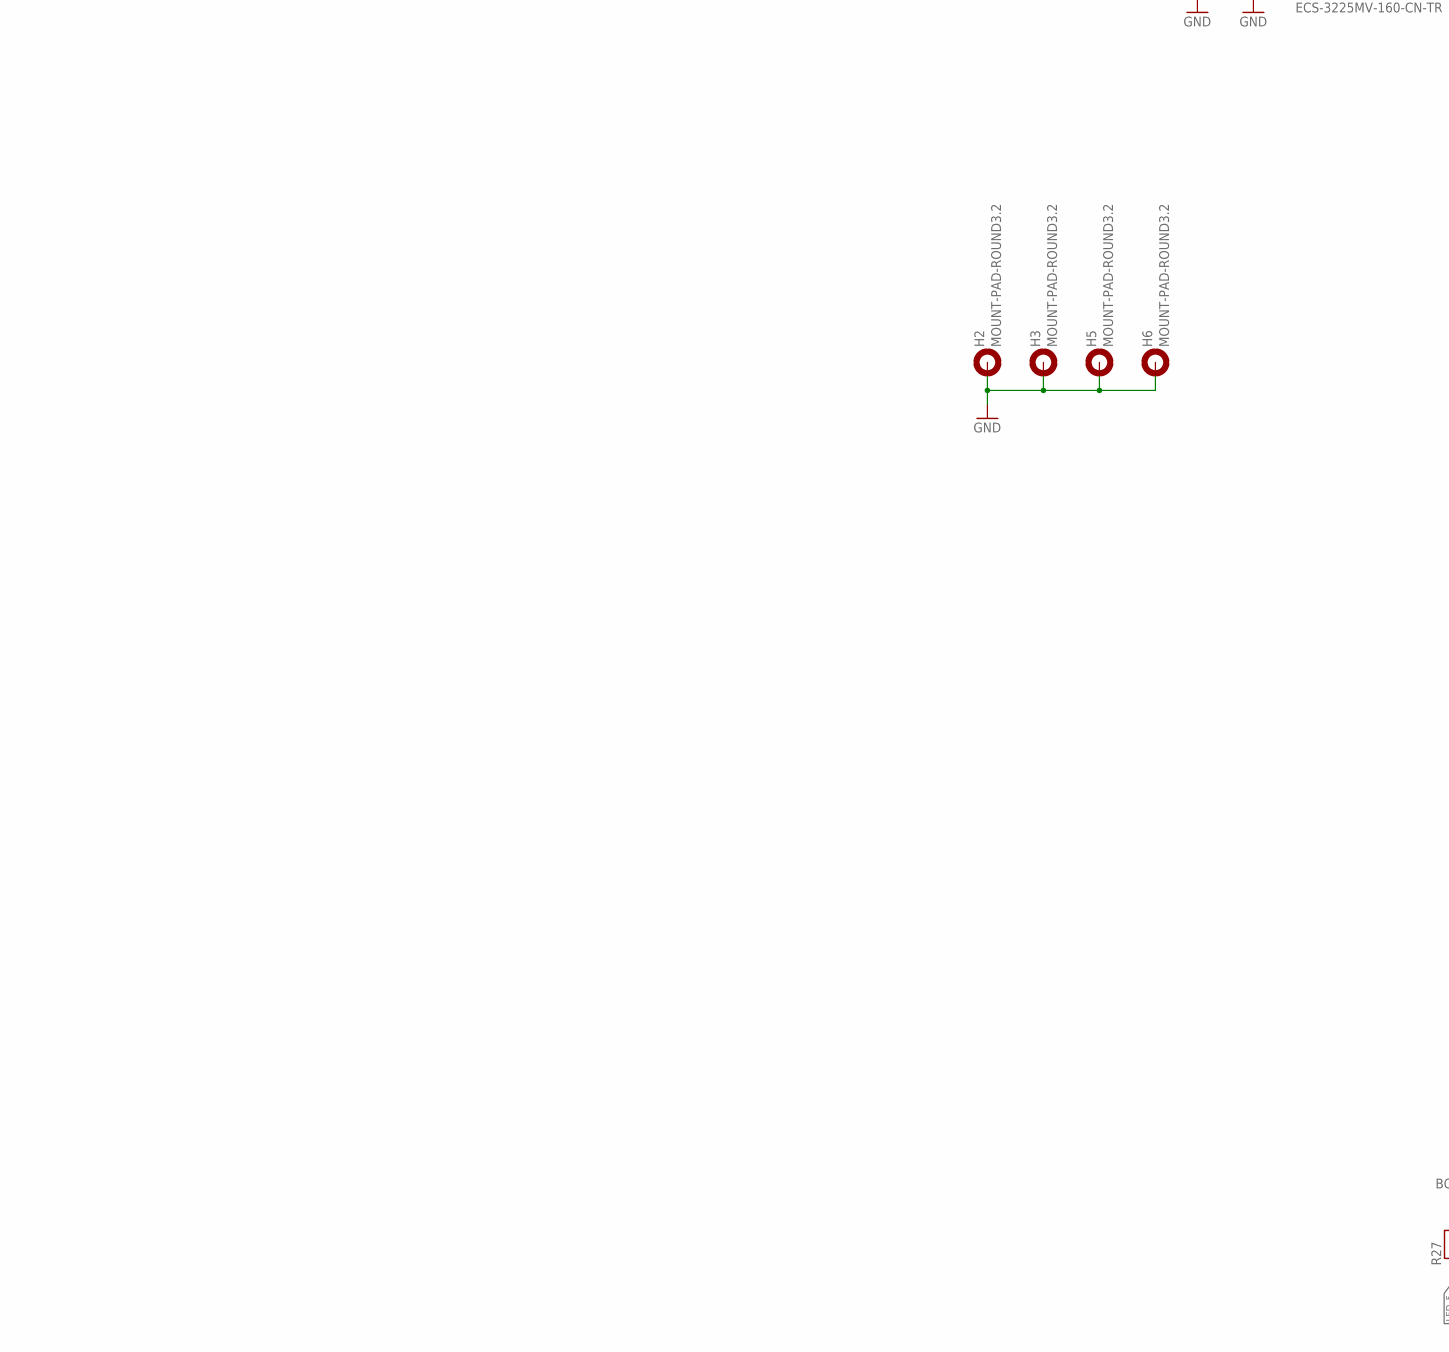
[picture p13: schematic mainboard.sch, part in row 2, column 1]

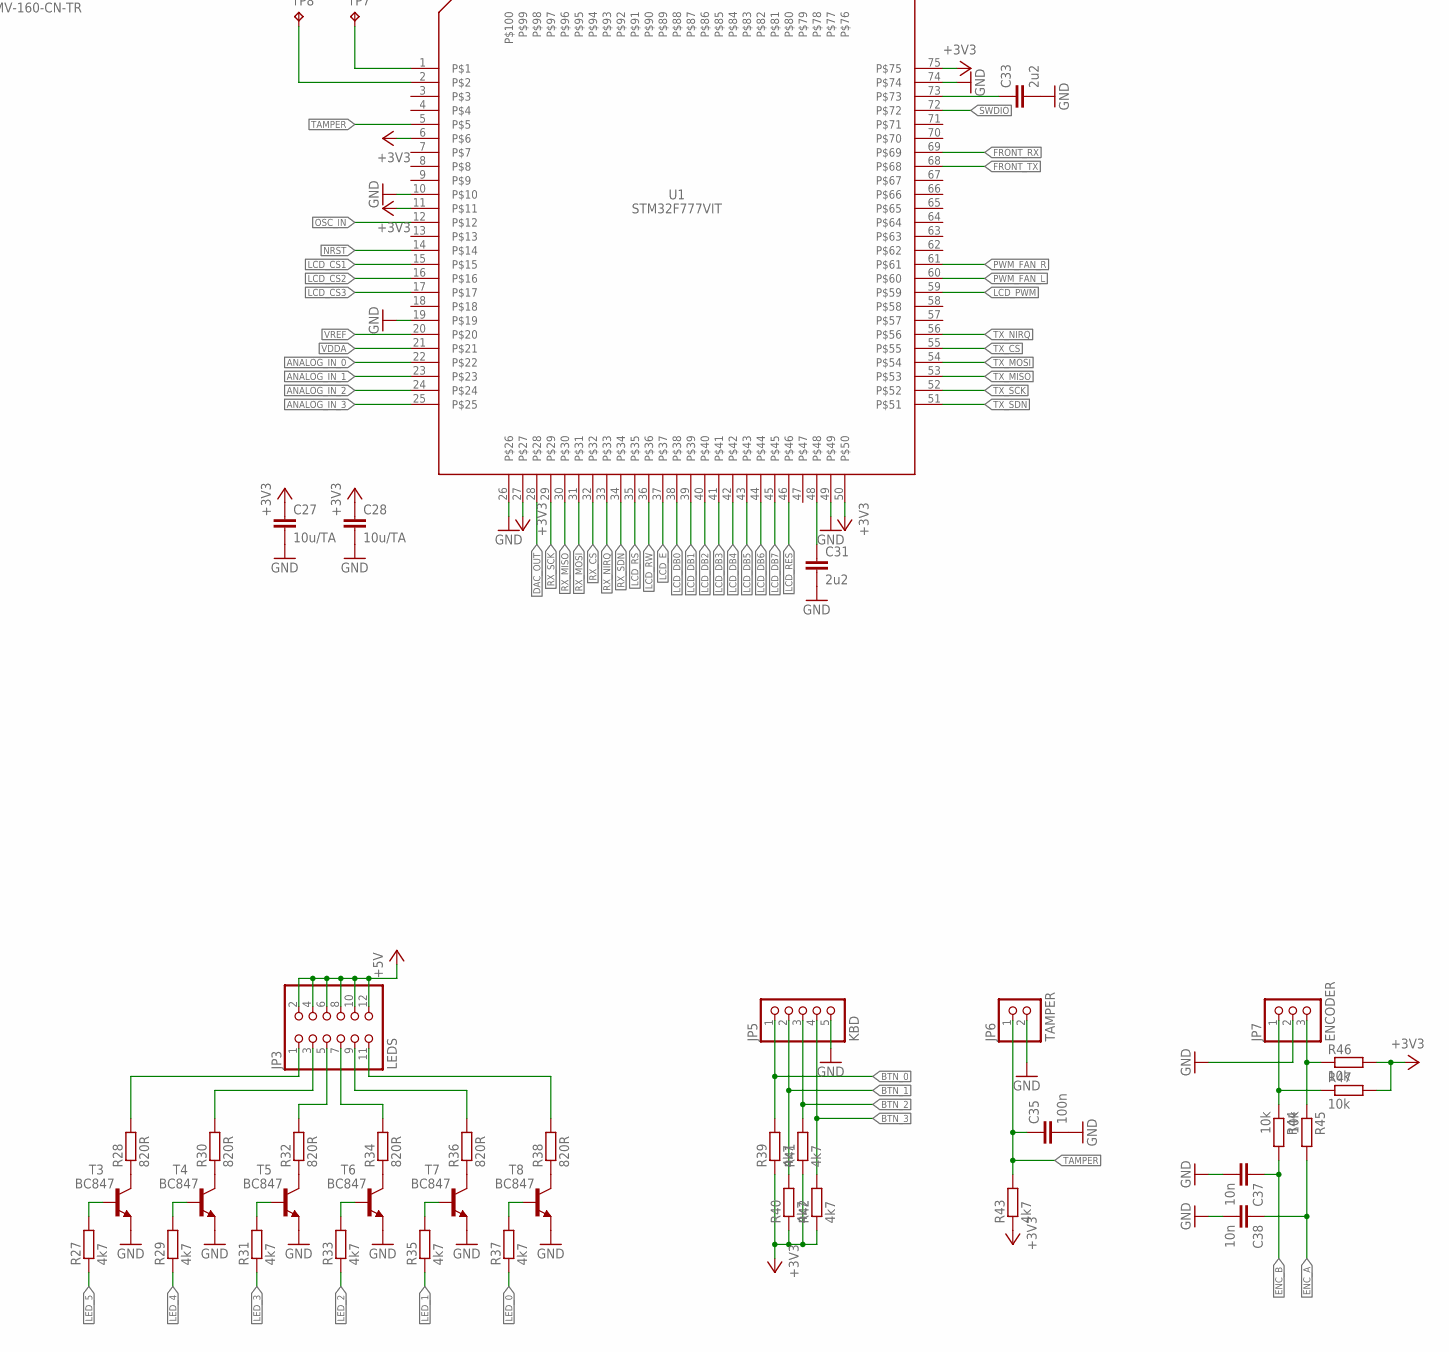
[picture p14: schematic mainboard.sch, part in row 2, column 2]

Parts:
C1, C2, C7, C8, C9, C10, C14, C15, C18, C19, C20, C22, C23, C24, C32, C35: 100n; C0805
C21, C37, C38: 10n; C0805
C27, C28: 10u/TA; C1206
C29, C30: 1000u/10V; E3,5-8
C31, C33: 2u2; C0805
D1: UF4007; DO41-7.6
H2, H3, H5, H6: MOUNT-PAD-ROUND3.2; 3,2-PAD
IC3: 74AHC00D; SO14
JP3: LEDS; 2X06
JP4: SWD; 1X05
JP5: KBD; 1X05
JP6: TAMPER; 1X02
JP7: ENCODER; 1X03
L1, L2, L3, L4, L5, L6: BEAD; 0204/7
L7, L8: BEAD; SM-B5
OS1: ECS-3225MV-160-CN-TR; 3.4X2.7-4-PAD
Q3: IRL520; TO220BV
R1: 10k; CA6V
R8: 0R; R1206
R19: 100R; R0805
R20, R44, R45, R46, R47, R48, R49: 10k; R0805
R27, R29, R31, R33, R35, R37, R39, R40, R41, R42, R43: 4k7; R0805
R28, R30, R32, R34, R36, R38: 820R; R0805
SV1: FRONT_LCD; ML26
SV2: RX_BOARD; ML10
SV3: FRONT_RJ45_SPK/MIC; MA04-2
SV4: FREQ REF; ML10
SV5: TX_BOARD; ML10
T3, T4, T5, T6, T7, T8: BC847; SOT23
TP7, TP8: TPB2,54; B2,54
U1: STM32F777VIT; LQFP100
X2: AK500/4

Connections:
32M_REF_IN_RX: IC3.6 (O), SV2.7
32M_REF_IN_TX: IC3.3 (O), SV5.7
32M_REF_OUT: IC3.2 (I1), IC3.4 (I0), SV4.4
+3V3: C8.1, C14.1, C21.1, C22.1, C27.1, C28.1, C29.+, C32.1, IC3.1 (I0), IC3.5 (I1), IC3.14 (VCC), JP4.5, L2.1, L4.2, L6.2, L7.1, L8.1, OS1.4 (VDD), R39.1, R40.1, R41.1, R42.1, R43.1, R46.2, R47.2, R48.2, U1.6, U1.11, U1.27, U1.50, U1.75, U1.100, X2.2
+5V: C2.2, C10.2, C18.2, C30.+, JP3.2, JP3.4, JP3.6, JP3.8, JP3.10, JP3.12, L1.2, L3.2, L5.2, R1.E, R8.2, X2.1
ANALOG_IN_0: SV3.6, U1.22
ANALOG_IN_1: U1.23
ANALOG_IN_2: U1.24
ANALOG_IN_3: U1.25
BTN_0: JP5.1, R39.2, U1.88
BTN_1: JP5.2, R40.2, U1.85
BTN_2: JP5.3, R41.2, U1.84
BTN_3: JP5.4, R42.2, U1.83
DAC_OUT: SV3.8, U1.28
ENC_A: C38.1, R45.2, U1.90
ENC_B: C37.1, R44.2, U1.91
ENC_BTN: U1.98
FRONT_PTT: R49.1, SV3.4, U1.97
FRONT_RX: SV3.3, U1.69
FRONT_TX: SV3.7, U1.68
GND: C1.1, C2.1, C7.1, C8.2, C9.1, C10.1, C14.2, C15.2, C18.1, C19.1, C20.1, C21.2, C22.2, C23.2, C24.2, C27.2, C28.2, C29.-, C30.-, C31.2, C32.2, C33.2, C35.2, C37.2, C38.2, H2.B3,2, H3.B3,2, H5.B3,2, H6.B3,2, IC3.7 (GND), IC3.9 (I0), IC3.10 (I1), IC3.12 (I0), IC3.13 (I1), JP4.1, JP5.5, JP6.2, JP7.2, OS1.2 (VSS), Q3.S, R1.A, R20.2, SV1.1, SV2.2, SV3.2, SV4.1, SV4.2, SV5.2, T3.2 (E), T4.2 (E), T5.2 (E), T6.2 (E), T7.2 (E), T8.2 (E), U1.10, U1.19, U1.26, U1.49, U1.74, U1.94, U1.99, X2.3, X2.4
LCD_A: D1.C, R8.1, SV1.20
LCD_CONTR: R1.S, SV1.3
LCD_CS1: SV1.16, U1.15
LCD_CS2: SV1.17, U1.16
LCD_CS3: SV1.18, U1.17
LCD_DB0: SV1.8, U1.38
LCD_DB1: SV1.9, U1.39
LCD_DB2: SV1.10, U1.40
LCD_DB3: SV1.11, U1.41
LCD_DB4: SV1.12, U1.42
LCD_DB5: SV1.13, U1.43
LCD_DB6: SV1.14, U1.44
LCD_DB7: SV1.15, U1.45
LCD_E: SV1.7, U1.37
LCD_K: D1.A, Q3.D, SV1.21
LCD_PWM: R19.2, U1.59
LCD_RES: SV1.19, U1.46
LCD_RS: SV1.5, U1.35
LCD_RW: SV1.6, U1.36
LED_0: R37.1, U1.77
LED_1: R35.1, U1.78
LED_2: R33.1, U1.79
LED_3: R31.1, U1.80
LED_4: R29.1, U1.81
LED_5: R27.1, U1.82
unnamed: Q3.G, R19.1, R20.1
unnamed: C15.1, L4.1, SV4.6, SV4.8, SV4.10
unnamed: C19.2, L5.1, SV4.5, SV4.7, SV4.9
unnamed: C20.2, L6.1, SV5.9, SV5.10
unnamed: C1.2, L1.1, SV1.2
unnamed: C7.2, L2.2, SV2.9, SV2.10
unnamed: C9.2, L3.1, R49.2, SV3.5
unnamed: C31.1, U1.48
unnamed: C33.1, U1.73
unnamed: R27.2, T3.1 (B)
unnamed: R28.1, T3.3 (C)
unnamed: JP3.1, R28.2
unnamed: JP3.3, R30.2
unnamed: R29.2, T4.1 (B)
unnamed: R30.1, T4.3 (C)
unnamed: JP3.5, R32.2
unnamed: R31.2, T5.1 (B)
unnamed: R32.1, T5.3 (C)
unnamed: JP3.7, R34.2
unnamed: R33.2, T6.1 (B)
unnamed: R34.1, T6.3 (C)
unnamed: JP3.9, R36.2
unnamed: R35.2, T7.1 (B)
unnamed: R36.1, T7.3 (C)
unnamed: JP3.11, R38.2
unnamed: R37.2, T8.1 (B)
unnamed: R38.1, T8.3 (C)
unnamed: TP7.TP, U1.1
unnamed: JP7.3, R45.1, R46.1
unnamed: JP7.1, R44.1, R47.1
unnamed: TP8.TP, U1.2
NRST: JP4.2, R48.1, U1.14
OSC_IN: OS1.3 (OUT), U1.12
PWM_FAN_L: U1.60
PWM_FAN_R: U1.61
RX_CS: SV2.5, U1.32
RX_MISO: SV2.3, U1.30
RX_MOSI: SV2.6, U1.31
RX_NIRQ: SV2.1, U1.33
RX_SCK: SV2.4, U1.29
RX_SDN: SV2.8, U1.34
SWCLK: JP4.3, U1.76
SWDIO: JP4.4, U1.72
TAMPER: C35.1, JP6.1, R43.2, U1.5
TX_CS: SV5.5, U1.55
TX_MISO: SV5.3, U1.53
TX_MOSI: SV5.6, U1.54
TX_NIRQ: SV5.1, U1.56
TX_SCK: SV5.4, U1.52
TX_SDN: SV5.8, U1.51
VDDA: C23.1, L8.2, U1.21
VREF: C24.1, L7.2, U1.20

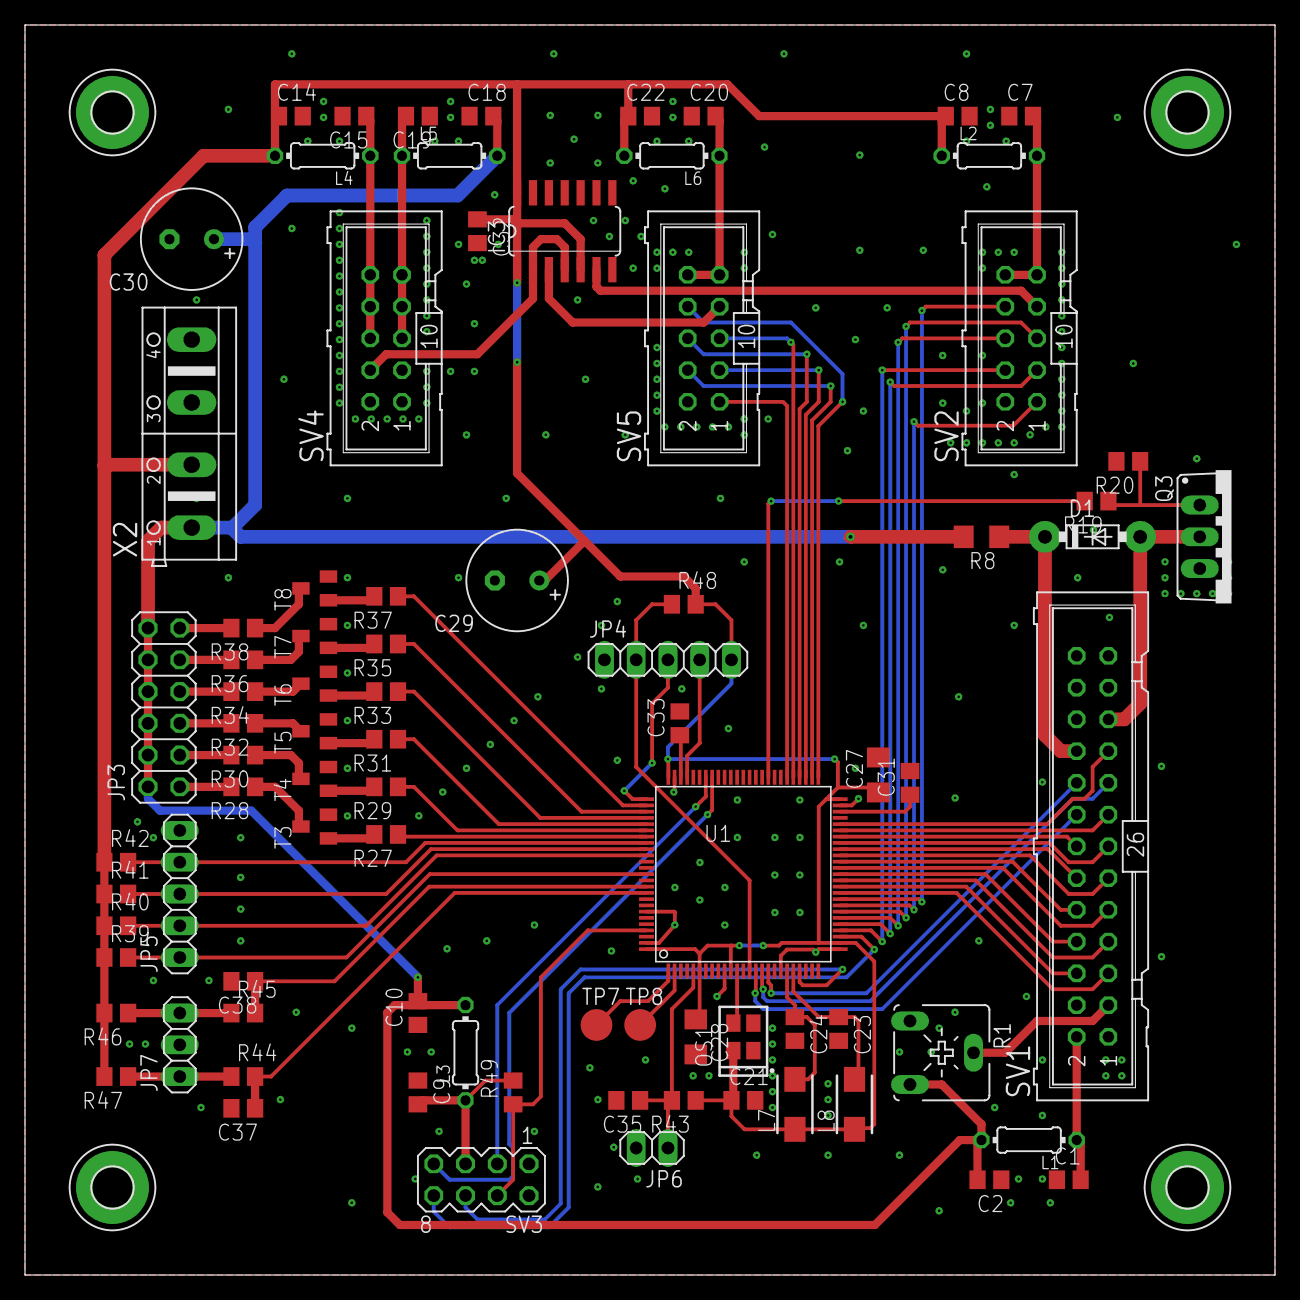
[picture p15: board mainboard.brd from above]

Board: 2 copper layers, 100.0 x 100.0 mm, 88 parts (0 on the bottom side), 92 nets.
