M17-Project/M17_Repeater/schematics/pa_board/main_new.brd

## EAGLE design schematics/pa_board/main_new.brd (2019-10-03)

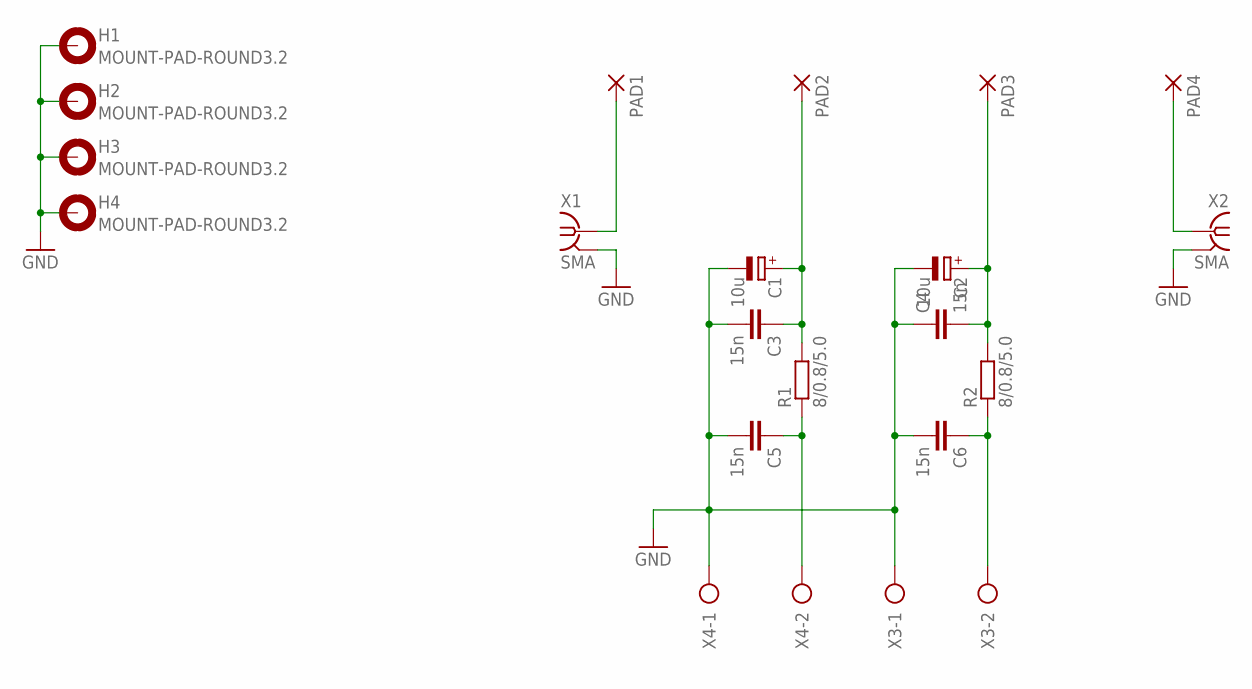
[picture p16: schematic main_new.sch]

Parts:
C1, C2: 10u; E5-8,5
C3, C4, C5, C6: 15n; C050-030X075
H1, H2, H3, H4: MOUNT-PAD-ROUND3.2; 3,2-PAD
PAD1, PAD2, PAD3, PAD4: SMD5; SMD2,54-5,08
R1, R2: 8/0.8/5.0; 0411/12
X1, X2: SMA; J502-ND-142-0711-821/826
X3, X4: AK500/2

Connections:
GND: C1.-, C2.-, C3.2, C4.1, C5.2, C6.2, H1.B3,2, H2.B3,2, H3.B3,2, H4.B3,2, X1.G@1 (2), X1.G@2 (2), X1.G@3 (2), X1.G@4 (2), X2.G@1 (2), X2.G@2 (2), X2.G@3 (2), X2.G@4 (2), X3.1, X4.1
unnamed: PAD1.1, X1.1
unnamed: PAD4.1, X2.1
unnamed: C6.1, R2.1, X3.2
unnamed: C2.+, C4.2, PAD3.1, R2.2
unnamed: C1.+, C3.1, PAD2.1, R1.2
unnamed: C5.1, R1.1, X4.2

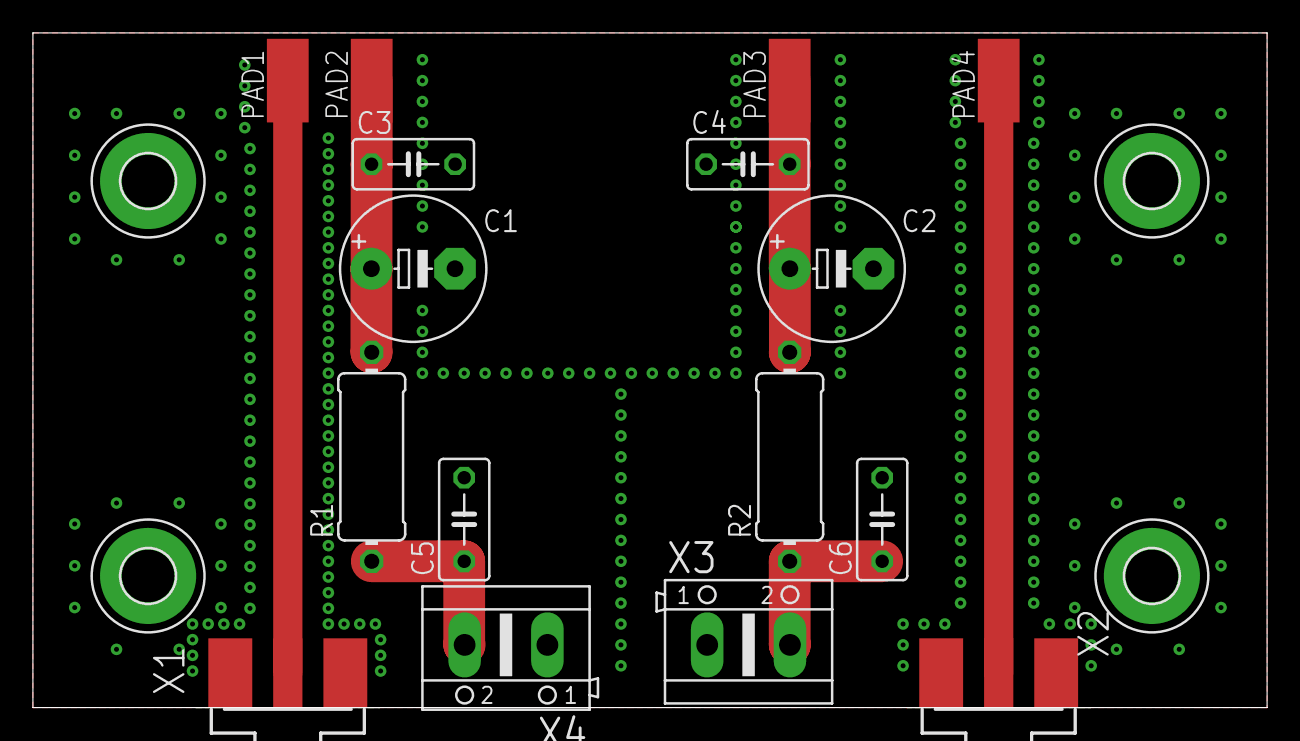
[picture p17: board main_new.brd from above]

Board: 2 copper layers, 75.0 x 41.0 mm, 20 parts (0 on the bottom side), 7 nets.
