M17-Project/M17_Repeater/schematics/tx_board/tx_board.brd

## EAGLE design schematics/tx_board/tx_board.brd (2019-07-21)

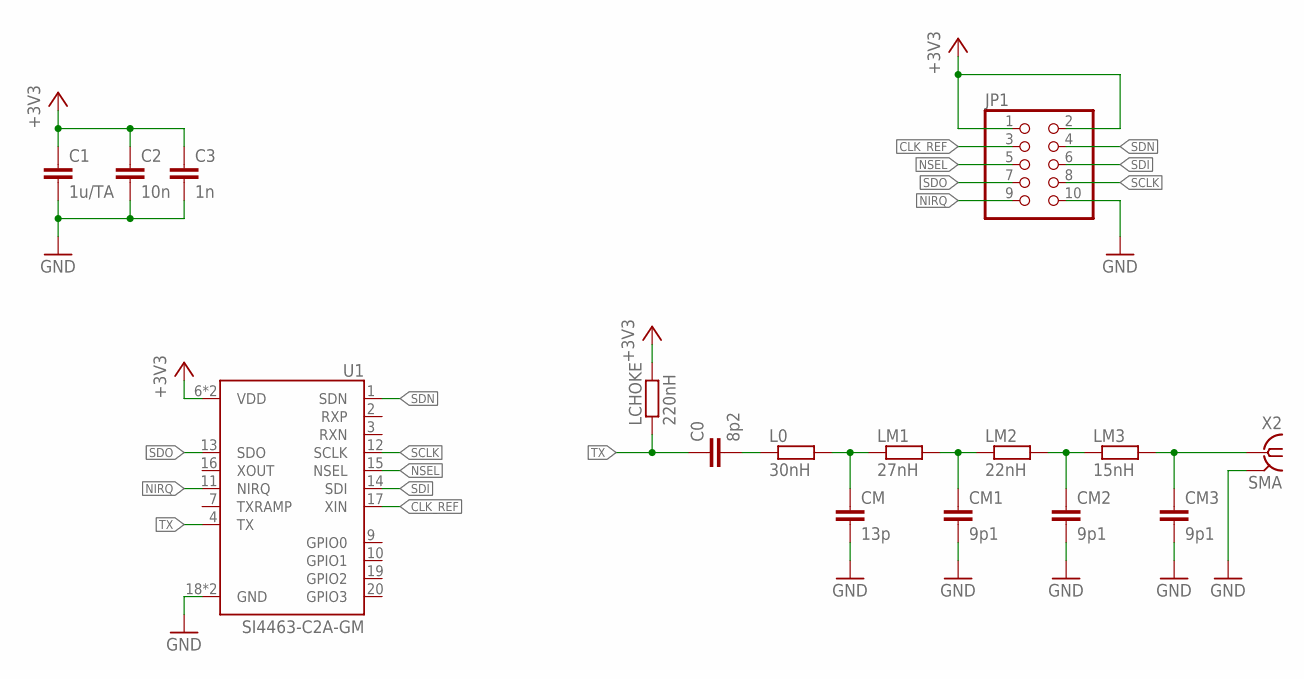
[picture p18: schematic tx_board.sch]

Parts:
C0: 8p2; C0805
C1: 1u/TA; C1206
C2: 10n; C0805
C3: 1n; C0805
CM: 13p; C0805
CM1, CM2, CM3: 9p1; C0805
JP1: PINHD-2X5/90; 2X05/90
L0: 30nH; R0805
LCHOKE: 220nH; R0805
LM1: 27nH; R0805
LM2: 22nH; R0805
LM3: 15nH; R0805
U1: SI4463-C2A-GM; QFN50P400X400X90-20N
X2: SMA; J502-ND-142-0701-871/876

Connections:
+3V3: C1.1, C2.1, C3.1, JP1.1, JP1.2, LCHOKE.2, U1.6 (VDD), U1.8 (VDD)
CLK_REF: JP1.3, U1.17 (XIN)
GND: C1.2, C2.2, C3.2, CM.2, CM1.2, CM2.2, CM3.2, JP1.10, U1.18 (GND), U1.21 (GND), X2.G@1 (2), X2.G@2 (2), X2.G@3 (2), X2.G@4 (2)
unnamed: CM2.1, LM2.2, LM3.1
unnamed: CM3.1, LM3.2, X2.1
unnamed: C0.2, L0.1
unnamed: CM.1, L0.2, LM1.1
unnamed: CM1.1, LM1.2, LM2.1
NIRQ: JP1.9, U1.11 (NIRQ)
NSEL: JP1.5, U1.15 (NSEL)
SCLK: JP1.8, U1.12 (SCLK)
SDI: JP1.6, U1.14 (SDI)
SDN: JP1.4, U1.1 (SDN)
SDO: JP1.7, U1.13 (SDO)
TX: C0.1, LCHOKE.1, U1.4 (TX)

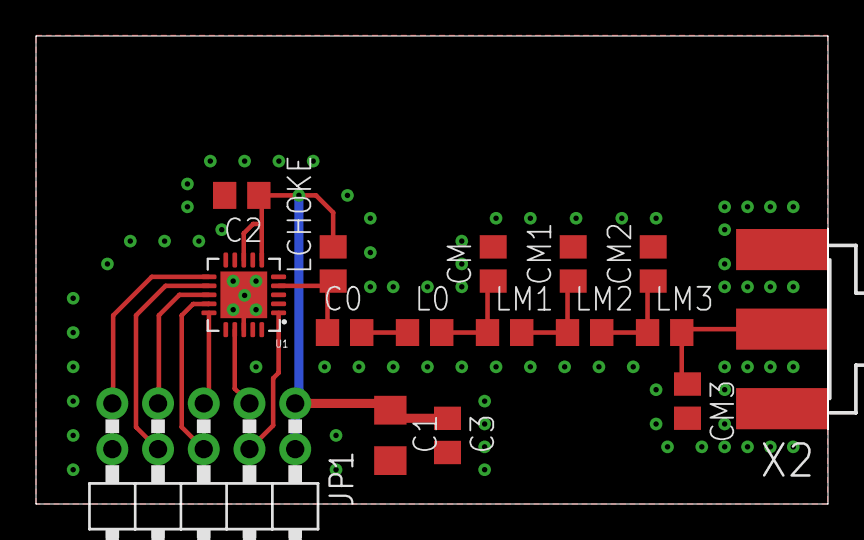
[picture p19: board tx_board.brd from above]

Board: 2 copper layers, 44.0 x 26.0 mm, 16 parts (0 on the bottom side), 15 nets.
