M17-Project/M17_Repeater/schematics/ref_board/ref_board.brd

## EAGLE design schematics/ref_board/ref_board.brd (2019-07-21)

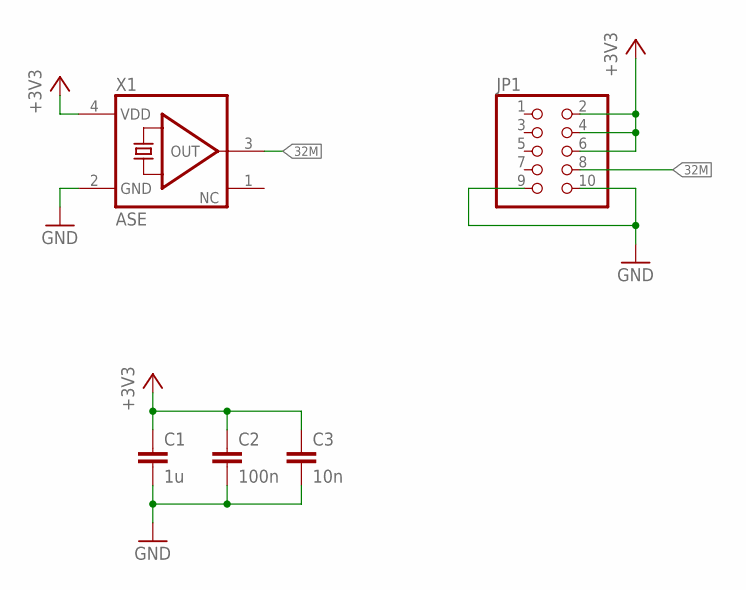
[picture p20: schematic ref_board.sch]

Parts:
C1: 1u; C1206
C2: 100n; C0805
C3: 10n; C0805
JP1: PINHD-2X5/90; 2X05/90
X1: ASE

Connections:
32M: JP1.8, X1.3 (OUT)
+3V3: C1.1, C2.1, C3.1, JP1.2, JP1.4, JP1.6, X1.4 (VDD)
GND: C1.2, C2.2, C3.2, JP1.9, JP1.10, X1.2 (GND)

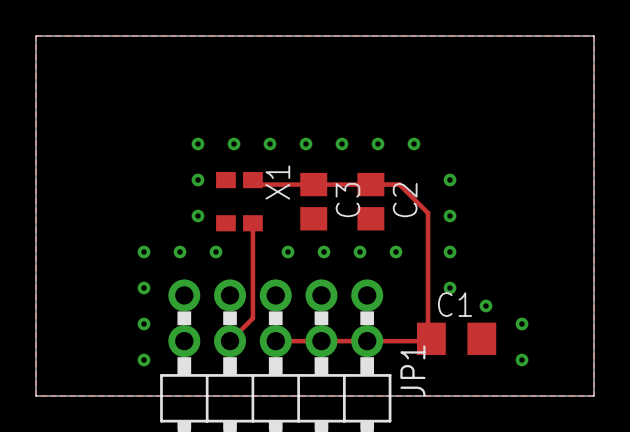
[picture p21: board ref_board.brd from above]

Board: 2 copper layers, 31.0 x 20.0 mm, 5 parts (0 on the bottom side), 3 nets.
