M17-Project/M17_Repeater/cubemx/Src/main.c

/**
  ******************************************************************************
  * @file           : main.c
  * @brief          : Main program body
  ******************************************************************************
  ** This notice applies to any and all portions of this file
  * that are not between comment pairs USER CODE BEGIN and
  * USER CODE END. Other portions of this file, whether 
  * inserted by the user or by software development tools
  * are owned by their respective copyright owners.
  *
  * COPYRIGHT(c) 2019 STMicroelectronics
  *
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
  ******************************************************************************
  */
/* Includes ------------------------------------------------------------------*/
#include "main.h"
#include "stm32f7xx_hal.h"

/* USER CODE BEGIN Includes */
#include "font.h"

#include "radio_config.h"

#define	FRAMESIZE		160*2					//20+20=40ms frame
#define	RAW_BYTES		8*2
#define	CRC_LEN			2
#define	ENC_LEN			(RAW_BYTES)*2
#define	PLOAD_LEN		93

#define	DC_OFFSET		2040					//input signal DC offset

#define	MAX_TX_POWER	0x7F					//+20dBm

#define SPLIT			7600000UL				//TX-RX split

#define UART_BUFF_LEN	130						//UART1 buffer length
/* USER CODE END Includes */

ADC_HandleTypeDef hadc1;

DAC_HandleTypeDef hdac;

SPI_HandleTypeDef hspi1;
SPI_HandleTypeDef hspi2;

TIM_HandleTypeDef htim3;
TIM_HandleTypeDef htim4;
TIM_HandleTypeDef htim6;

UART_HandleTypeDef huart1;
DMA_HandleTypeDef hdma_usart1_tx;

/* USER CODE BEGIN PV */
//Si 446x RELATED
const uint8_t config[] = RADIO_CONFIGURATION_DATA_ARRAY;	//config
volatile uint8_t RX_ints[8];								//interrupts
volatile uint8_t r_initd=0;									//RX initialized?

volatile uint8_t rcv_buff[PLOAD_LEN];						//Si RX buffer

//main
volatile uint32_t tx_freq=439075000;						//TX frequency in Hz
volatile uint32_t rx_freq=431475000;						//RX

//QSO
volatile uint32_t last_id_from=0;
volatile uint32_t last_id_to=0;
volatile uint8_t  content_type=0;
volatile uint8_t  encr_type=0;

//UART
volatile uint8_t rx_buff[UART_BUFF_LEN];
volatile uint8_t tx_buff[UART_BUFF_LEN];
volatile uint8_t rx_cnt=0;									//where in rx buffer are we?

//TIMERS
volatile uint8_t tim_6_initd=0;								//first tim6 irq cleared?
/* USER CODE END PV */

void SystemClock_Config(void);
static void MX_GPIO_Init(void);
static void MX_DMA_Init(void);
static void MX_ADC1_Init(void);
static void MX_DAC_Init(void);
static void MX_SPI2_Init(void);
static void MX_TIM4_Init(void);
static void MX_USART1_UART_Init(void);
static void MX_SPI1_Init(void);
static void MX_TIM3_Init(void);
static void MX_TIM6_Init(void);

void HAL_TIM_MspPostInit(TIM_HandleTypeDef *htim);
                                

/* USER CODE BEGIN PFP */
//------------------------------SPI1 - Si4463 - RX------------------------------
void RX_WaitForCTS(void)
{
	uint8_t cts[1]={0x00};
	const uint8_t dta[1]={0x44};

	do
	{
		HAL_GPIO_WritePin(RX_CS_GPIO_Port, RX_CS_Pin, 0);
		HAL_SPI_Transmit(&hspi1, dta, 1, 100);
		HAL_SPI_Receive(&hspi1, cts, 1, 100);
		//if(cts[0]!=0xFF)
			HAL_GPIO_WritePin(RX_CS_GPIO_Port, RX_CS_Pin, 1);
	}while(cts[0]!=0xFF);
}

void RX_Send(uint8_t *data, uint8_t len)
{
	RX_WaitForCTS();
	HAL_GPIO_WritePin(RX_CS_GPIO_Port, RX_CS_Pin, 0);
	HAL_SPI_Transmit(&hspi1, data, len, 100);
	HAL_GPIO_WritePin(RX_CS_GPIO_Port, RX_CS_Pin, 1);
}

void RX_GetResponse(uint8_t len, uint8_t *data)
{
	uint8_t cts[1]={0x00};
	uint8_t dta[1]={0x44};

	while(cts[0]!=0xFF)
	{
		HAL_GPIO_WritePin(RX_CS_GPIO_Port, RX_CS_Pin, 0);
		HAL_SPI_Transmit(&hspi1, dta, 1, 100);
		HAL_SPI_Receive(&hspi1, cts, 1, 1);

		if(cts[0]!=0xFF)
			HAL_GPIO_WritePin(RX_CS_GPIO_Port, RX_CS_Pin, 1);
	}

	HAL_SPI_Receive(&hspi1, data, len, 100);

	HAL_GPIO_WritePin(RX_CS_GPIO_Port, RX_CS_Pin, 1);
}

void RX_ReadRxDataBuff(uint8_t len, uint8_t *data)
{
	uint8_t cmd[1]={0x77};

	HAL_GPIO_WritePin(RX_CS_GPIO_Port, RX_CS_Pin, 0);
	HAL_SPI_Transmit(&hspi1, cmd, 1, 100);
	HAL_SPI_Receive(&hspi1, data, len, 100);
	HAL_GPIO_WritePin(RX_CS_GPIO_Port, RX_CS_Pin, 1);
}

//------------------------------SPI2 - Si4463 - TX------------------------------
void TX_WaitForCTS(void)
{
	uint8_t cts[1]={0x00};
	const uint8_t dta[1]={0x44};

	do
	{
		HAL_GPIO_WritePin(TX_CS_GPIO_Port, TX_CS_Pin, 0);
		HAL_SPI_Transmit(&hspi2, dta, 1, 100);
		HAL_SPI_Receive(&hspi2, cts, 1, 100);
		//if(cts[0]!=0xFF)
			HAL_GPIO_WritePin(TX_CS_GPIO_Port, TX_CS_Pin, 1);
	}while(cts[0]!=0xFF);
}

void TX_Send(uint8_t *data, uint8_t len)
{
	TX_WaitForCTS();
	HAL_GPIO_WritePin(TX_CS_GPIO_Port, TX_CS_Pin, 0);
	HAL_SPI_Transmit(&hspi2, data, len, 100);
	HAL_GPIO_WritePin(TX_CS_GPIO_Port, TX_CS_Pin, 1);
}

void TX_GetResponse(uint8_t len, uint8_t *data)
{
	uint8_t cts[1]={0x00};
	uint8_t dta[1]={0x44};

	while(cts[0]!=0xFF)
	{
		HAL_GPIO_WritePin(TX_CS_GPIO_Port, TX_CS_Pin, 0);
		HAL_SPI_Transmit(&hspi2, dta, 1, 100);
		HAL_SPI_Receive(&hspi2, cts, 1, 1);

		if(cts[0]!=0xFF)
			HAL_GPIO_WritePin(TX_CS_GPIO_Port, TX_CS_Pin, 1);
	}

	HAL_SPI_Receive(&hspi2, data, len, 100);

	HAL_GPIO_WritePin(TX_CS_GPIO_Port, TX_CS_Pin, 1);
}

void TX_WriteTxDataBuff(uint8_t *data, uint8_t len)
{
	uint8_t cmd = 0x66;

	HAL_GPIO_WritePin(TX_CS_GPIO_Port, TX_CS_Pin, 0);
	HAL_SPI_Transmit(&hspi2, &cmd, 1, 100);
	HAL_SPI_Transmit(&hspi2, data, len, 100);
	HAL_GPIO_WritePin(TX_CS_GPIO_Port, TX_CS_Pin, 1);
}

//------------------------------RX Si4463 FUNCS------------------------------
void RX_Reset(void)
{
	HAL_GPIO_WritePin(RX_SDN_GPIO_Port, RX_SDN_Pin, 1);
	HAL_Delay(5);
	HAL_GPIO_WritePin(RX_SDN_GPIO_Port, RX_SDN_Pin, 0);
	HAL_Delay(5);
}

static void RX_SetProp(uint8_t* vals, uint8_t group, uint8_t number, uint8_t len)
{
	uint8_t data[16]={0x11,	group, len, number};

	memcpy(data + 4, vals, len);

	RX_WaitForCTS();
	RX_Send(data, len + 4);
}

static void RX_StartupConfig(void)
{
	uint8_t buff[17];

	for(uint16_t i=0; i<sizeof(config); i++)
	{
		memcpy(buff, &config[i], sizeof(buff));
		RX_WaitForCTS();
		RX_Send(&buff[1], buff[0]);
		i += buff[0];
	}
}

static void RX_Interrupts(void* buff)
{
	uint8_t data = 0x20;

	RX_Send(&data, 1);
	if(buff!=NULL)
		RX_GetResponse(8, buff);
}

/*static void RX_InterruptsNoCTS(void* buff)
{
	uint8_t v = 0x20;

	HAL_GPIO_WritePin(RX_CS_GPIO_Port, RX_CS_Pin, 0);
	HAL_SPI_Transmit(&hspi1, &v, 1, 100);
	HAL_SPI_Receive(&hspi1, buff, 8, 100);
	HAL_GPIO_WritePin(RX_CS_GPIO_Port, RX_CS_Pin, 1);
}*/

static void RX_Interrupts2(void* buff, uint8_t clearPH, uint8_t clearMODEM, uint8_t clearCHIP)
{
	uint8_t data[] = {
		0x20,
		clearPH,
		clearMODEM,
		clearCHIP
	};

	RX_Send(data, 4);
	if(buff!=NULL)
		RX_GetResponse(8, buff);
}

static uint8_t RX_GetState(void)
{
	uint8_t state[2]={0, 0};
	uint8_t get_state_cmd=0x33;

	RX_WaitForCTS();
	RX_Send(&get_state_cmd, 1);
	RX_GetResponse(2, state);

	return state[0]&0x0F;
}

static void RX_SetState(uint8_t newState)
{
	uint8_t data[2]={0x34, newState};

	RX_Send(data, 2);
}

void RX_Sleep(void)
{
	uint8_t state=RX_GetState();

	if(state==7 || state==5)
		return;

	RX_SetState(1);
}

void RX_ClearFIFO(uint8_t fifos)
{
	uint8_t msg[3]={0x15, fifos};

	RX_Send(&msg, 2);
}

void RX_StartRx(uint8_t ch, uint8_t len)
{
	//RX_SetState(3);		//RX state
	RX_ClearFIFO(3);	//clear both FIFOs
	//RX_Interrupts2(NULL, 0, 0, 0xFF);	//clear some interrupts

	uint8_t msg[8]={0x32, ch, 0, 0, len, 0x08, 0x08, 0x08};

	RX_Send(msg, 8);
}

void RX_FreqSet(uint32_t freq)	//freq in Hz
{
	uint8_t inte=0x3C;	//default values
	uint64_t frac=0x00080000;

	freq=freq*(30.0/32.0);
	inte=freq/7500000-1;
	frac=(freq-(uint32_t)(inte+1)*7500000)/75;
	frac=(uint64_t)frac*(1<<19)/100000+(uint32_t)(1<<19);

	uint8_t vals[4]={inte, (frac>>16)&0xFF, (frac>>8)&0xFF, frac&0xFF};

	RX_SetProp(&vals, 0x40, 0x00, 4);
}

uint8_t RX_GetRSSI(void)
{
	uint8_t v=0x50;
	uint8_t r[4];

	HAL_GPIO_WritePin(RX_CS_GPIO_Port, RX_CS_Pin, 0);
	HAL_SPI_Transmit(&hspi1, &v, 1, 100);
	HAL_SPI_Receive(&hspi1, r, 4, 100);
	HAL_GPIO_WritePin(RX_CS_GPIO_Port, RX_CS_Pin, 1);

	return r[0];
}

void RX_GetInfo(uint8_t *resp)
{
	uint8_t cmd=0x01;

	RX_Send(&cmd, 1);
	RX_WaitForCTS();
	RX_GetResponse(8, resp);
}

uint8_t RX_Check(void)
{
	uint8_t info[8];

	RX_GetInfo(info);

	if(info[1]==0x44 && info[2]==0x63)
		return 0;

	return 1;
}

//------------------------------TX Si4463 FUNCS------------------------------
void TX_Reset(void)
{
	HAL_GPIO_WritePin(TX_SDN_GPIO_Port, TX_SDN_Pin, 1);
	HAL_Delay(5);
	HAL_GPIO_WritePin(TX_SDN_GPIO_Port, TX_SDN_Pin, 0);
	HAL_Delay(5);
}

static void TX_SetProp(uint8_t* vals, uint8_t group, uint8_t number, uint8_t len)
{
	uint8_t data[16]={0x11,	group, len, number};

	memcpy(data + 4, vals, len);

	TX_WaitForCTS();
	TX_Send(data, len + 4);
}

static void TX_StartupConfig(void)
{
	uint8_t buff[17];

	for(uint16_t i=0; i<sizeof(config); i++)
	{
		memcpy(buff, &config[i], sizeof(buff));
		TX_WaitForCTS();
		TX_Send(&buff[1], buff[0]);
		i += buff[0];
	}
}

static void TX_Interrupts(void* buff)
{
	uint8_t data = 0x20;

	TX_Send(&data, 1);
	if(buff!=NULL)
		TX_GetResponse(8, buff);
}

/*static void TX_InterruptsNoCTS(void* buff)
{
	uint8_t v = 0x20;

	HAL_GPIO_WritePin(TX_CS_GPIO_Port, TX_CS_Pin, 0);
	HAL_SPI_Transmit(&hspi2, &v, 1, 100);
	HAL_SPI_Receive(&hspi21, buff, 8, 100);
	HAL_GPIO_WritePin(TX_CS_GPIO_Port, TX_CS_Pin, 1);
}*/

static void TX_Interrupts2(void* buff, uint8_t clearPH, uint8_t clearMODEM, uint8_t clearCHIP)
{
	uint8_t data[] = {
		0x20,
		clearPH,
		clearMODEM,
		clearCHIP
	};

	TX_Send(data, 4);
	if(buff!=NULL)
		TX_GetResponse(8, buff);
}

static uint8_t TX_GetState(void)
{
	uint8_t state[2]={0, 0};
	uint8_t get_state_cmd=0x33;

	TX_WaitForCTS();
	TX_Send(&get_state_cmd, 1);
	TX_GetResponse(2, state);

	return state[0]&0x0F;
}

static void TX_SetState(uint8_t newState)
{
	uint8_t data[2]={0x34, newState};

	TX_Send(data, 2);
}

void TX_Sleep(void)
{
	uint8_t state=TX_GetState();

	if(state==7 || state==5)
		return;

	TX_SetState(1);
}

void TX_ClearFIFO(uint8_t fifos)
{
	uint8_t msg[3]={0x15, fifos};

	TX_Send(&msg, 2);
}

void TX_SetTxPower(uint8_t pwr)
{
	/*uint8_t msg[5]={0x11, 0x22, 0x01, 0x01, pwr};

	TX_Send(&msg, 5);*/
	TX_SetProp(&pwr, 0x22, 0x01, 1);
}

void TX_StartTx(uint8_t ch, uint8_t end_state, uint8_t tx_len)
{
	uint8_t msg[7]={0x31, ch, (uint8_t)end_state<<4, 0, tx_len, 0, 0};

	TX_WaitForCTS();
	TX_Send(&msg, 7);
}

void TX_TxData(uint8_t *d, uint8_t len, uint8_t ch)
{
	TX_ClearFIFO(3);
	TX_Interrupts2(NULL, 0, 0, 0xFF);

	TX_WriteTxDataBuff(d, len);
	TX_StartTx(ch, 3, len);	//3 - READY state after TX complete
}

void TX_FreqSet(uint32_t freq)	//freq in Hz
{
	uint8_t inte=0x3C;	//default values
	uint64_t frac=0x00080000;

	freq=freq*(30.0/32.0);
	inte=freq/7500000-1;
	frac=(freq-(uint32_t)(inte+1)*7500000)/75;
	frac=(uint64_t)frac*(1<<19)/100000+(uint32_t)(1<<19);

	uint8_t vals[4]={inte, (frac>>16)&0xFF, (frac>>8)&0xFF, frac&0xFF};

	TX_SetProp(&vals, 0x40, 0x00, 4);
}

void TX_GetInfo(uint8_t *resp)
{
	uint8_t cmd=0x01;

	TX_Send(&cmd, 1);
	TX_WaitForCTS();
	TX_GetResponse(8, resp);
}

uint8_t TX_Check(void)
{
	uint8_t info[8];

	TX_GetInfo(info);

	if(info[1]==0x44 && info[2]==0x63)
		return 0;

	return 1;
}

//----------------------------------MISC FUNCS---------------------------------
void Delay(uint32_t val)
{
	for(uint32_t i=0; i<val; i++)
		__ASM volatile("NOP");
}

//----------------------------------LCD FUNCS----------------------------------
/*void LCD_Wait(void)
{
	HAL_GPIO_WritePin(RS_GPIO_Port, RS_Pin, 0);
	for(uint8_t i=0; i<100; i++);
	HAL_GPIO_WritePin(RW_GPIO_Port, RW_Pin, 1);
	for(uint8_t i=0; i<100; i++);
	GPIOD->MODER&=~0x0000;
	while((GPIOD->IDR)&0x80);
	GPIOD->MODER=0x5555;
}*/

void LCD_Init(void)
{
	HAL_GPIO_WritePin(LCD_E_GPIO_Port, LCD_E_Pin, 0);
	HAL_Delay(5);
	HAL_GPIO_WritePin(LCD_RES_GPIO_Port, LCD_RES_Pin, 1);
	HAL_Delay(50);
	HAL_GPIO_WritePin(LCD_RES_GPIO_Port, LCD_RES_Pin, 0);
	HAL_Delay(250);
	HAL_GPIO_WritePin(LCD_RES_GPIO_Port, LCD_RES_Pin, 1);
	HAL_Delay(50);
}
void LCD_SetX(uint8_t x)
{
	HAL_GPIO_WritePin(LCD_RS_GPIO_Port, LCD_RS_Pin, 0);
	HAL_GPIO_WritePin(LCD_RW_GPIO_Port, LCD_RW_Pin, 0);
	Delay(200);
	GPIOE->ODR&=0x00FF; GPIOE->ODR|=(uint32_t)(0b10111000|x)<<8;
	Delay(200);
	HAL_GPIO_WritePin(LCD_E_GPIO_Port, LCD_E_Pin, 1);
	Delay(200);
	HAL_GPIO_WritePin(LCD_E_GPIO_Port, LCD_E_Pin, 0);
	Delay(200);
}

void LCD_SetY(uint8_t y)
{
	HAL_GPIO_WritePin(LCD_RS_GPIO_Port, LCD_RS_Pin, 0);
	HAL_GPIO_WritePin(LCD_RW_GPIO_Port, LCD_RW_Pin, 0);
	Delay(200);
	GPIOE->ODR&=0x00FF; GPIOE->ODR|=(uint32_t)(0b01000000|y)<<8;
	Delay(200);
	HAL_GPIO_WritePin(LCD_E_GPIO_Port, LCD_E_Pin, 1);
	Delay(200);
	HAL_GPIO_WritePin(LCD_E_GPIO_Port, LCD_E_Pin, 0);
	Delay(200);
}

void LCD_SetZ(uint8_t z)
{
	HAL_GPIO_WritePin(LCD_RS_GPIO_Port, LCD_RS_Pin, 0);
	HAL_GPIO_WritePin(LCD_RW_GPIO_Port, LCD_RW_Pin, 0);
	Delay(200);
	GPIOE->ODR&=0x00FF; GPIOE->ODR|=(uint32_t)(0b11000000|z)<<8;
	Delay(200);
	HAL_GPIO_WritePin(LCD_E_GPIO_Port, LCD_E_Pin, 1);
	Delay(200);
	HAL_GPIO_WritePin(LCD_E_GPIO_Port, LCD_E_Pin, 0);
	Delay(200);
}

void LCD_WriteData(uint8_t dta)
{
	HAL_GPIO_WritePin(LCD_RS_GPIO_Port, LCD_RS_Pin, 1);
	HAL_GPIO_WritePin(LCD_RW_GPIO_Port, LCD_RW_Pin, 0);
	Delay(200);
	GPIOE->ODR&=0x00FF; GPIOE->ODR|=(uint32_t)dta<<8;
	Delay(200);
	HAL_GPIO_WritePin(LCD_E_GPIO_Port, LCD_E_Pin, 1);
	Delay(200);
	HAL_GPIO_WritePin(LCD_E_GPIO_Port, LCD_E_Pin, 0);
	Delay(200);
}

void LCD_Disp(uint8_t ena)
{
	HAL_GPIO_WritePin(LCD_RS_GPIO_Port, LCD_RS_Pin, 0);
	HAL_GPIO_WritePin(LCD_RW_GPIO_Port, LCD_RW_Pin, 0);
	Delay(200);
	GPIOE->ODR&=0xFF00; GPIOE->ODR|=(uint32_t)(0b00111110|ena)<<8;
	Delay(200);
	HAL_GPIO_WritePin(LCD_E_GPIO_Port, LCD_E_Pin, 1);
	Delay(200);
	HAL_GPIO_WritePin(LCD_E_GPIO_Port, LCD_E_Pin, 0);
	Delay(200);
}

void LCD_Clear(void)
{
	HAL_GPIO_WritePin(LCD_CS1_GPIO_Port, LCD_CS1_Pin, 0);
	HAL_GPIO_WritePin(LCD_CS2_GPIO_Port, LCD_CS2_Pin, 0);
	HAL_GPIO_WritePin(LCD_CS3_GPIO_Port, LCD_CS3_Pin, 0);

	LCD_Disp(0);

	LCD_SetZ(0);

	for(uint8_t x=0; x<8; x++)
	{
		for(uint8_t y=0; y<64; y++)
		{
			LCD_SetX(x);
			LCD_SetY(y);
			LCD_WriteData(0);
		}
	}

	LCD_Disp(1);
}

//1 - 6x8; 2 - 12x16
void LCD_PutStrFast(uint8_t x, uint8_t y, uint8_t *str, uint8_t font)
{
	uint8_t k=0;
	LCD_SetZ(0);
	if(font==1)
	{
		for(uint j=0; j<strlen(str); j++)
		{
			for(uint8_t i=0; i<6; i++)
			{
				if((x+k+i)<64)
				{
					HAL_GPIO_WritePin(LCD_CS1_GPIO_Port, LCD_CS1_Pin, 0);
					HAL_GPIO_WritePin(LCD_CS2_GPIO_Port, LCD_CS2_Pin, 1);
					HAL_GPIO_WritePin(LCD_CS3_GPIO_Port, LCD_CS3_Pin, 1);
				}
				else if((x+k+i)<128)
				{
					HAL_GPIO_WritePin(LCD_CS1_GPIO_Port, LCD_CS1_Pin, 1);
					HAL_GPIO_WritePin(LCD_CS2_GPIO_Port, LCD_CS2_Pin, 0);
					HAL_GPIO_WritePin(LCD_CS3_GPIO_Port, LCD_CS3_Pin, 1);
				}
				else
				{
					HAL_GPIO_WritePin(LCD_CS1_GPIO_Port, LCD_CS1_Pin, 1);
					HAL_GPIO_WritePin(LCD_CS2_GPIO_Port, LCD_CS2_Pin, 1);
					HAL_GPIO_WritePin(LCD_CS3_GPIO_Port, LCD_CS3_Pin, 0);
				}

				LCD_SetX(y);
				LCD_SetY((x+k+i)%64);
				LCD_WriteData(font_6x8[str[j]][i]);
			}

			k+=6;
		}
	}
	else if(font==2)
	{
		for(uint j=0; j<strlen(str); j++)
		{
			for(uint8_t i=0; i<24; i++)
			{
				if((x+k+i/2)<64)
				{
					HAL_GPIO_WritePin(LCD_CS1_GPIO_Port, LCD_CS1_Pin, 0);
					HAL_GPIO_WritePin(LCD_CS2_GPIO_Port, LCD_CS2_Pin, 1);
					HAL_GPIO_WritePin(LCD_CS3_GPIO_Port, LCD_CS3_Pin, 1);
				}
				else if((x+k+i/2)<128)
				{
					HAL_GPIO_WritePin(LCD_CS1_GPIO_Port, LCD_CS1_Pin, 1);
					HAL_GPIO_WritePin(LCD_CS2_GPIO_Port, LCD_CS2_Pin, 0);
					HAL_GPIO_WritePin(LCD_CS3_GPIO_Port, LCD_CS3_Pin, 1);
				}
				else
				{
					HAL_GPIO_WritePin(LCD_CS1_GPIO_Port, LCD_CS1_Pin, 1);
					HAL_GPIO_WritePin(LCD_CS2_GPIO_Port, LCD_CS2_Pin, 1);
					HAL_GPIO_WritePin(LCD_CS3_GPIO_Port, LCD_CS3_Pin, 0);
				}

				LCD_SetX(y+i%2);
				LCD_SetY((x+k+i/2)%64);
				LCD_WriteData(font_12x16[str[j]][i]);
			}

			k+=12;
		}
	}
}

//------------------------------------PWMs-------------------------------------
void LCD_Blight(uint8_t perc)
{
	if(perc<101)
		TIM4->CCR1=perc;
	else
		TIM4->CCR1=100;

	HAL_TIM_PWM_Start(&htim4, TIM_CHANNEL_1);
}

/*void L_Fan_RPM(uint8_t perc)
{
	if(perc<101)
		TIM4->CCR2=perc;
	else
		TIM4->CCR2=100;

	HAL_TIM_PWM_Start(&htim4, TIM_CHANNEL_2);
}

void R_Fan_RPM(uint8_t perc)
{
	if(perc<101)
		TIM4->CCR3=perc;
	else
		TIM4->CCR3=100;

	HAL_TIM_PWM_Start(&htim4, TIM_CHANNEL_3);
}*/

//------------------------------------MISC-------------------------------------
void Tamper_check(void)
{
	if(HAL_GPIO_ReadPin(TAMPER_GPIO_Port, TAMPER_Pin))
	{
		LCD_PutStrFast(0, 7, "CASE OPEN", 1);
		HAL_GPIO_WritePin(LED_4_GPIO_Port, LED_4_Pin, 1);
	}
	else
	{
		LCD_PutStrFast(0, 7, "         ", 1);
		HAL_GPIO_WritePin(LED_4_GPIO_Port, LED_4_Pin, 0);
	}
}

HAL_StatusTypeDef HAL_UART_AbortReceive_IT(UART_HandleTypeDef *huart)
{
	/* Disable RXNE, PE and ERR (Frame error, noise error, overrun error) interrupts */
	CLEAR_BIT(huart->Instance->CR1, (USART_CR1_RXNEIE | USART_CR1_PEIE));
	CLEAR_BIT(huart->Instance->CR3, USART_CR3_EIE);

	/* Disable the UART DMA Rx request if enabled */
	if(HAL_IS_BIT_SET(huart->Instance->CR3, USART_CR3_DMAR))
	{
		CLEAR_BIT(huart->Instance->CR3, USART_CR3_DMAR);

		/* Abort the UART DMA Rx channel : use blocking DMA Abort API (no callback) */
		//if(huart->hdmarx != NULL)
		{
			/* Set the UART DMA Abort callback :
 	 	 	 will lead to call HAL_UART_AbortCpltCallback() at end of DMA abort procedure */
			//huart->hdmarx->XferAbortCallback = UART_DMARxOnlyAbortCallback;

			/* Abort DMA RX */
			//if(HAL_DMA_Abort_IT(huart->hdmarx) != HAL_OK)
			{
				/* Call Directly huart->hdmarx->XferAbortCallback function in case of error */
				//huart->hdmarx->XferAbortCallback(huart->hdmarx);
			}
		}
		//else
		{
			/* Reset Rx transfer counter */
			huart->RxXferCount = 0x00U;

			/* Restore huart->RxState to Ready */
			huart->RxState = HAL_UART_STATE_READY;

			/* As no DMA to be aborted, call directly user Abort complete callback */
			//HAL_UART_AbortReceiveCpltCallback(huart);
		}
	}
	else
	{
		/* Reset Rx transfer counter */
		huart->RxXferCount = 0x00U;

		/* Restore huart->RxState to Ready */
		huart->RxState = HAL_UART_STATE_READY;

		/* As no DMA to be aborted, call directly user Abort complete callback */
		//HAL_UART_AbortReceiveCpltCallback(huart);
	}

	return HAL_OK;
}

//------------------------------IRQ HANDLER FUNCS------------------------------
void HAL_GPIO_EXTI_Callback(uint16_t GPIO_Pin)
{
	//RX_NIRQ
	if(GPIO_Pin==GPIO_PIN_5 && r_initd==1)
	{
		RX_Interrupts(RX_ints);	//check pending interrupt flags

		//PACKET_RX_PEND flag set?
		if(RX_ints[2]&(1<<4))
		{
			HAL_GPIO_TogglePin(LED_0_GPIO_Port, LED_0_Pin);
			RX_ReadRxDataBuff(PLOAD_LEN, rcv_buff);
			RX_ClearFIFO(3);

			content_type=(rcv_buff[0]>>6)&3;
			encr_type=(rcv_buff[0]>>4)&3;

			uint32_t now_id_from=(rcv_buff[19]<<16) | (rcv_buff[20]<<8) | rcv_buff[21];
			uint32_t now_id_to=(rcv_buff[22]<<16) | (rcv_buff[23]<<8) | rcv_buff[24];

			TX_TxData(rcv_buff, PLOAD_LEN, 0);
			HAL_UART_Transmit(&huart1, "A", 1, 100); //TODO: append full "AT+FRAME=..\r\n"
			HAL_UART_Transmit_DMA(&huart1, rcv_buff, PLOAD_LEN);

			if(last_id_from!=now_id_from)
				last_id_from=now_id_from;
			if(last_id_to!=now_id_to)
				last_id_to=now_id_to;

			uint8_t s[20];
			if(!encr_type)
			{
				sprintf(s, "->  %07d  ", last_id_from);
				LCD_PutStrFast(102, 2, s, 1);
				sprintf(s, "<-  %07d  ", last_id_to);
				LCD_PutStrFast(102, 3, s, 1);
				LCD_PutStrFast(102+4*6, 0, "    ", 1);
			}
			else
			{
				LCD_PutStrFast(102, 2, "-> (UNKNOWN)", 1);
				LCD_PutStrFast(102, 3, "<- (UNKNOWN)", 1);
				LCD_PutStrFast(102+4*6, 0, "ENCR", 1);
			}

		}

		//clear pending flags
		RX_Interrupts(NULL);
	}
	else if(GPIO_Pin==TAMPER_Pin)
	{
		Tamper_check();
	}
}

void HAL_UART_RxCpltCallback(UART_HandleTypeDef *huart)
{
	if(huart->Instance==USART1)
	{
		rx_cnt++;

		if(rx_buff[0]=='A' && rx_buff[1]=='T' && rx_buff[2]=='+')
		{
			if(rx_buff[3]=='F' && rx_buff[4]=='R')
			{
				if(rx_buff[5]=='A' && rx_buff[6]=='M' && rx_buff[7]=='E' && rx_buff[PLOAD_LEN+9]=='\r' && rx_buff[PLOAD_LEN+10]=='\n')
				{
					HAL_TIM_Base_Stop_IT(&htim6);
					TIM6->CNT=0;
					TX_TxData(&rx_buff[9], PLOAD_LEN, 0);
					memset(rx_buff, 0, UART_BUFF_LEN);
					rx_cnt=0;
					HAL_UART_Receive_IT(&huart1, rx_buff, 1);
				}
			}
		}

		HAL_UART_Receive_IT(&huart1, &rx_buff[rx_cnt], 1);
		TIM6->CNT=0;
		HAL_TIM_Base_Start_IT(&htim6);
	}
}

void HAL_TIM_PeriodElapsedCallback(TIM_HandleTypeDef *htim)
{
	if(htim->Instance==TIM6)
	{
		if(tim_6_initd)
		{
			HAL_UART_AbortReceive_IT(&huart1);
			HAL_TIM_Base_Stop_IT(&htim6);
			TIM6->CNT=0;
			memset(rx_buff, 0, UART_BUFF_LEN);
			rx_cnt=0;
			HAL_UART_Receive_IT(&huart1, rx_buff, 1);
		}
		else
		{
			HAL_TIM_Base_Stop_IT(&htim6);
			TIM6->CNT=0;
			tim_6_initd=1;
		}
	}
}
/* USER CODE END PFP */

/**
  * @brief  The application entry point.
  *
  * @retval None
  */
int main(void)
{
  /* MCU Configuration----------------------------------------------------------*/

  /* Reset of all peripherals, Initializes the Flash interface and the Systick. */
  HAL_Init();

  /* Configure the system clock */
  SystemClock_Config();

  /* Initialize all configured peripherals */
  MX_GPIO_Init();
  MX_DMA_Init();
  MX_ADC1_Init();
  MX_DAC_Init();
  MX_SPI2_Init();
  MX_TIM4_Init();
  MX_USART1_UART_Init();
  MX_SPI1_Init();
  MX_TIM3_Init();
  MX_TIM6_Init();
  /* USER CODE BEGIN 2 */
  memset(rx_buff, 0, UART_BUFF_LEN);
  memset(tx_buff, 0, UART_BUFF_LEN);
  //HAL_TIM_Base_Start_IT(&htim6);
  HAL_UART_Receive_IT(&huart1, rx_buff, 1);
  HAL_Delay(100);

  HAL_GPIO_WritePin(LCD_CS1_GPIO_Port, LCD_CS1_Pin, 0);
  HAL_GPIO_WritePin(LCD_CS2_GPIO_Port, LCD_CS2_Pin, 0);
  HAL_GPIO_WritePin(LCD_CS3_GPIO_Port, LCD_CS3_Pin, 0);

  LCD_Init();
  LCD_Clear();

  RX_Reset();
  TX_Reset();

  if(RX_Check() || TX_Check())	//fucked up comms with either one of Si4463
  {
	  while(1)
	  {
		  HAL_GPIO_TogglePin(LED_5_GPIO_Port, LED_5_Pin);
		  HAL_Delay(200);
	  }
  }

  RX_StartupConfig(); TX_StartupConfig();
  RX_Interrupts(NULL); TX_Interrupts(NULL);
  RX_FreqSet(rx_freq); TX_FreqSet(tx_freq);
  RX_Sleep(); TX_Sleep();
  RX_StartRx(0, PLOAD_LEN);
  TX_SetTxPower(3);//MAX_TX_POWER);
  r_initd=1;

  LCD_Blight(50); //50
  //L_Fan_RPM(20);
  //R_Fan_RPM(20);

  LCD_PutStrFast(0, 0, "SR5MS", 2); LCD_PutStrFast(102, 0, "ACT", 1);

  uint8_t line[20];
  sprintf(line, "RX %d", rx_freq);
  memmove(&line[7], &line[6], 4);
  line[6]='.';
  sprintf(&line[11], "MHz");
  LCD_PutStrFast(0, 2, line, 1);
  sprintf(line, "TX %d", tx_freq);
  memmove(&line[7], &line[6], 4);
  line[6]='.';
  sprintf(&line[11], "MHz");
  LCD_PutStrFast(0, 3, line, 1);

  Tamper_check();
  HAL_UART_Transmit(&huart1, "BOOT_OK\n", 9, 100);

  /* USER CODE END 2 */

  /* Infinite loop */
  /* USER CODE BEGIN WHILE */
  while (1)
  {
	  HAL_GPIO_TogglePin(LED_0_GPIO_Port, LED_0_Pin);
	  HAL_Delay(200);
	  //TX_TxData("1234567890123456789012345678901234567890123456789012345678901234567890123456789012345678901234567", PLOAD_LEN, 0);
  /* USER CODE END WHILE */

  /* USER CODE BEGIN 3 */

  }
  /* USER CODE END 3 */

}

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
