M17-Project/M17_Repeater/cubemx/M17_Repeater.ioc

Mcu.UserName=STM32F777VITx
PA0/WKUP.Signal=ADCx_IN0
PA1.Signal=ADCx_IN1
PA10.Signal=USART1_RX
PA13.Signal=SYS_JTMS-SWDIO
PA14.Signal=SYS_JTCK-SWCLK
PA15.GPIO_Label=LED_0
PA15.Signal=GPIO_Output
PA2.Signal=ADCx_IN2
PA3.Signal=ADCx_IN3
PA4.Signal=COMP_DAC1_group
PA5.GPIO_Label=RX_SCK
PA5.Signal=SPI1_SCK
PA6.GPIO_Label=RX_MISO
PA6.Signal=SPI1_MISO
PA7.GPIO_Label=RX_MOSI
PA7.Signal=SPI1_MOSI
PA9.Signal=USART1_TX
PB0.GPIO_Label=RX_SDN
PB0.Signal=GPIO_Output
PB1.GPIO_Label=LCD_RS
PB1.Signal=GPIO_Output
PB10.GPIO_Label=LCD_RES
PB10.Signal=GPIO_Output
PB12.GPIO_Label=TX_SDN
PB12.Signal=GPIO_Output
PB13.GPIO_Label=TX_SCK
PB13.Signal=SPI2_SCK
PB14.GPIO_Label=TX_MISO
PB14.Signal=SPI2_MISO
PB15.GPIO_Label=TX_MOSI
PB15.Signal=SPI2_MOSI
PB2.GPIO_Label=LCD_RW
PB2.Signal=GPIO_Output
PB4.GPIO_Label=ENC_B
PB4.Signal=S_TIM3_CH1
PB5.GPIO_Label=ENC_A
PB5.Signal=S_TIM3_CH2
PC0.GPIO_Label=LCD_CS1
PC0.Signal=GPIO_Output
PC1.GPIO_Label=LCD_CS2
PC1.Signal=GPIO_Output
PC10.GPIO_Label=LED_1
PC10.Signal=GPIO_Output
PC11.GPIO_Label=LED_2
PC11.Signal=GPIO_Output
PC12.GPIO_Label=LED_3
PC12.Signal=GPIO_Output
PC2.GPIO_Label=LCD_CS3
PC2.Signal=GPIO_Output
PC4.GPIO_Label=RX_CS
PC4.Signal=GPIO_Output
PC5.GPIO_Label=RX_NIRQ
PC5.Signal=GPXTI5
PD0.GPIO_Label=LED_4
PD0.Signal=GPIO_Output
PD1.GPIO_Label=LED_5
PD1.Signal=GPIO_Output
PD12.GPIO_Label=LCD_PWM
PD12.Signal=S_TIM4_CH1
PD13.GPIO_Label=PWM_FAN_L
PD13.Signal=S_TIM4_CH2
PD14.GPIO_Label=PWM_FAN_R
PD14.Signal=S_TIM4_CH3
PD2.GPIO_Label=BTN_3
PD2.Signal=GPXTI2
PD3.GPIO_Label=BTN_2
PD3.Signal=GPXTI3
PD4.GPIO_Label=BTN_1
PD4.Signal=GPXTI4
PD7.GPIO_Label=BTN_0
PD7.Signal=GPXTI7
PD8.GPIO_Label=TX_CS
PD8.Signal=GPIO_Output
PD9.GPIO_Label=TX_NIRQ
PD9.Signal=GPXTI9
PE0.GPIO_Label=PTT
PE0.Signal=GPXTI0
PE1.GPIO_Label=ENC_BTN
PE1.Signal=GPXTI1
PE10.GPIO_Label=LCD_DB2
PE10.Signal=GPIO_Output
PE11.GPIO_Label=LCD_DB3
PE11.Signal=GPIO_Output
PE12.GPIO_Label=LCD_DB4
PE12.Signal=GPIO_Output
PE13.GPIO_Label=LCD_DB5
PE13.Signal=GPIO_Output
PE14.GPIO_Label=LCD_DB6
PE14.Signal=GPIO_Output
PE15.GPIO_Label=LCD_DB7
PE15.Signal=GPIO_Output
PE2.GPIO_Label=TP7
PE2.Signal=GPIO_Output
PE3.GPIO_Label=TP8
PE3.Signal=GPIO_Output
PE6.GPIO_Label=TAMPER
PE6.Signal=GPXTI6
PE7.GPIO_Label=LCD_E
PE7.Signal=GPIO_Output
PE8.GPIO_Label=LCD_DB0
PE8.Signal=GPIO_Output
PE9.GPIO_Label=LCD_DB1
PE9.Signal=GPIO_Output
PH0/OSC_IN.Signal=RCC_OSC_IN
PH1/OSC_OUT.Signal=RCC_OSC_OUT
