M17-Project/M17_Repeater/(notices)

Notices in the files:
cubemx/Inc/main.h:
(C) COPYRIGHT STMicroelectronics *****END OF FILE
